md-sazzad-eee/ATLAS/02_electronics/agent_controller/atlas_agent_ctrl_schematic.png

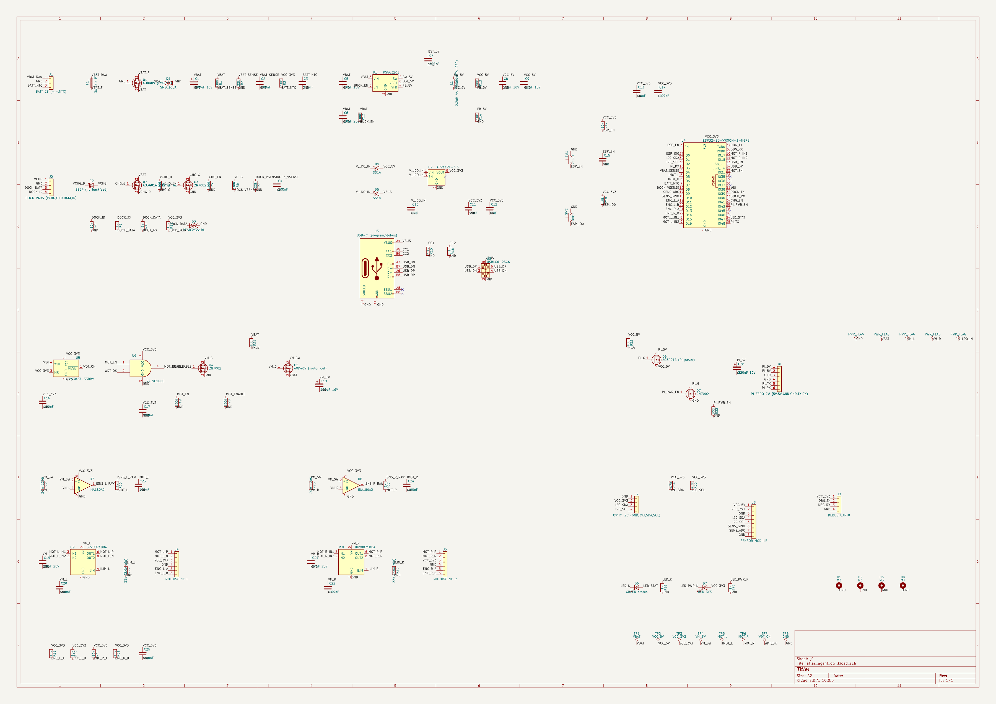
02_electronics/agent_controller/atlas_agent_ctrl_schematic.png
