md-sazzad-eee/ATLAS/02_electronics/agent_controller/board_top_render.png

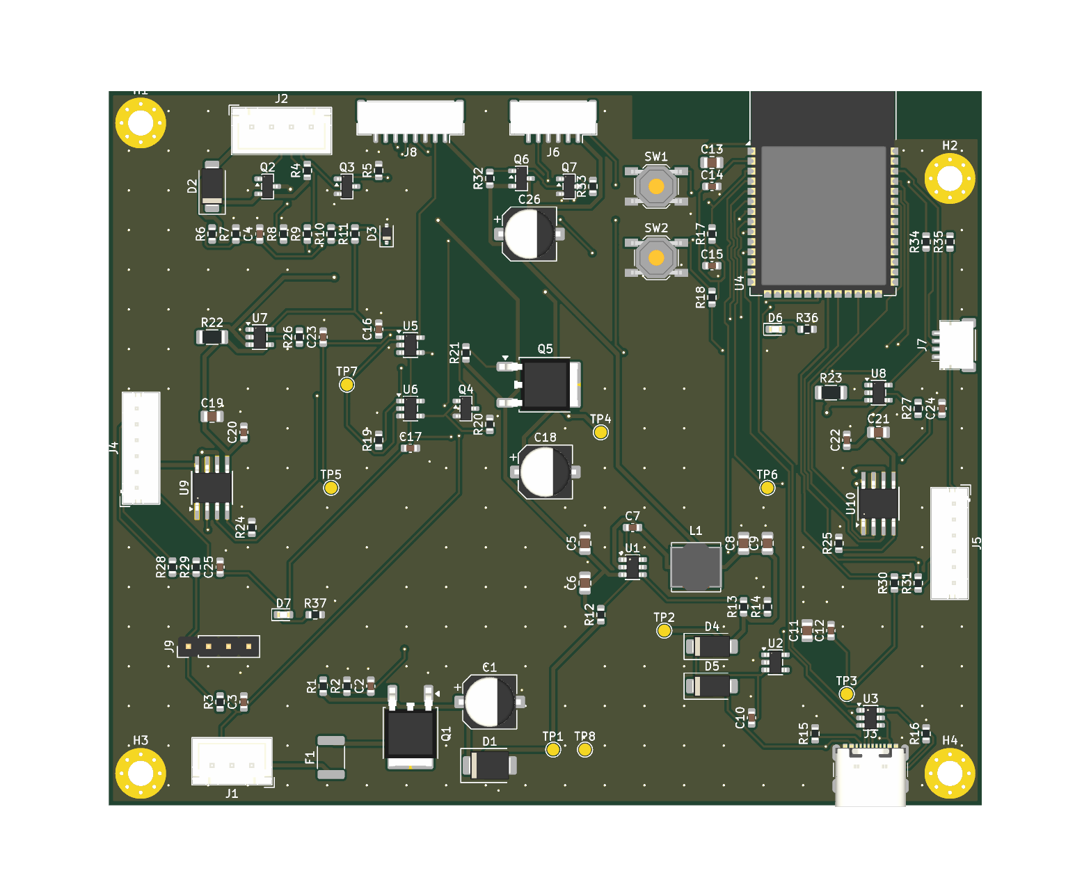
02_electronics/agent_controller/board_top_render.png
