md-sazzad-eee/ATLAS/05_simulation/matlab/results/torque_speed_requirements.png

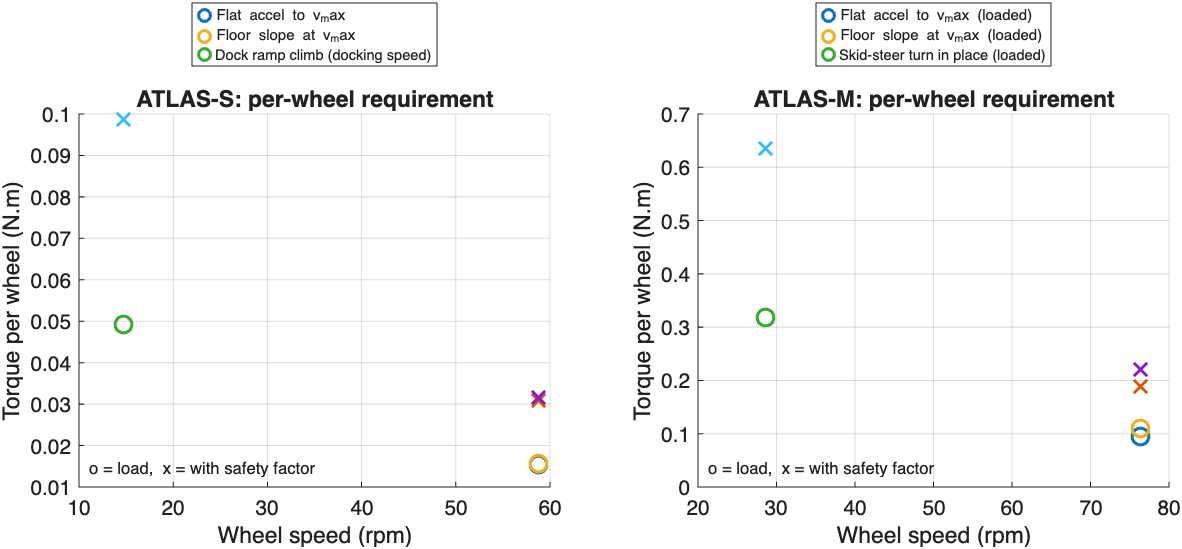
05_simulation/matlab/results/torque_speed_requirements.png
