md-sazzad-eee/ATLAS/07_documentation/figures/agent_boardB_fit.png

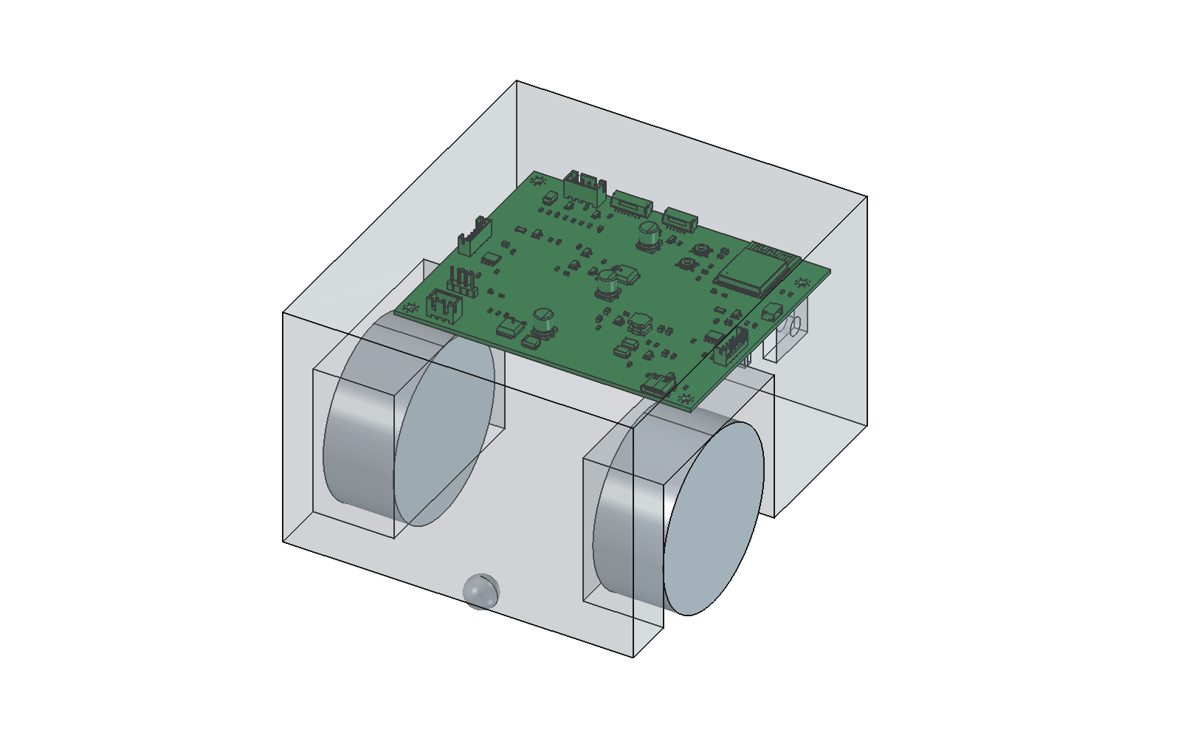
07_documentation/figures/agent_boardB_fit.png
