md-sazzad-eee/ATLAS/02_electronics/agent_controller/fab/atlas_agent_ctrl_bom.csv

Refs | Value | Footprint | Qty | DNP
C1 | 100uF 16V | Capacitor_SMD:CP_Elec_6.3x7.7 | 1
C2 | 100nF | Capacitor_SMD:C_0603_1608Metric | 1
C3 | 100nF | Capacitor_SMD:C_0603_1608Metric | 1
C4 | 100nF | Capacitor_SMD:C_0603_1608Metric | 1
C5 | 10uF 25V | Capacitor_SMD:C_0805_2012Metric | 1
C6 | 10uF 25V | Capacitor_SMD:C_0805_2012Metric | 1
C7 | 100nF | Capacitor_SMD:C_0603_1608Metric | 1
C8 | 22uF 10V | Capacitor_SMD:C_0805_2012Metric | 1
C9 | 22uF 10V | Capacitor_SMD:C_0805_2012Metric | 1
C10 | 1uF | Capacitor_SMD:C_0603_1608Metric | 1
C11 | 10uF | Capacitor_SMD:C_0805_2012Metric | 1
C12 | 1uF | Capacitor_SMD:C_0603_1608Metric | 1
C13 | 10uF | Capacitor_SMD:C_0805_2012Metric | 1
C14 | 100nF | Capacitor_SMD:C_0603_1608Metric | 1
C15 | 1uF | Capacitor_SMD:C_0603_1608Metric | 1
C16 | 100nF | Capacitor_SMD:C_0603_1608Metric | 1
C17 | 100nF | Capacitor_SMD:C_0603_1608Metric | 1
C18 | 100uF 16V | Capacitor_SMD:CP_Elec_6.3x7.7 | 1
C19 | 10uF 25V | Capacitor_SMD:C_0805_2012Metric | 1
C20 | 100nF | Capacitor_SMD:C_0603_1608Metric | 1
C21 | 10uF 25V | Capacitor_SMD:C_0805_2012Metric | 1
C22 | 100nF | Capacitor_SMD:C_0603_1608Metric | 1
C23 | 100nF | Capacitor_SMD:C_0603_1608Metric | 1
C24 | 100nF | Capacitor_SMD:C_0603_1608Metric | 1
C25 | 100nF | Capacitor_SMD:C_0603_1608Metric | 1
C26 | 220uF 10V | Capacitor_SMD:CP_Elec_6.3x7.7 | 1
D1 | SMBJ10CA | Diode_SMD:D_SMB | 1
D2 | SS34 (no backfeed) | Diode_SMD:D_SMA | 1
D3 | PESD3V3S1BL | Diode_SMD:D_SOD-323 | 1
D4 | SS14 | Diode_SMD:D_SMA | 1
D5 | SS14 | Diode_SMD:D_SMA | 1
D6 | GREEN status | LED_SMD:LED_0603_1608Metric | 1
D7 | RED 3V3 | LED_SMD:LED_0603_1608Metric | 1
F1 | 3A hold PTC | Fuse:Fuse_1812_4532Metric | 1
H1 | M3 | MountingHole:MountingHole_3.2mm_M3_Pad_Via | 1
H2 | M3 | MountingHole:MountingHole_3.2mm_M3_Pad_Via | 1
H3 | M3 | MountingHole:MountingHole_3.2mm_M3_Pad_Via | 1
H4 | M3 | MountingHole:MountingHole_3.2mm_M3_Pad_Via | 1
J1 | BATT 2S (+,-,NTC) | Connector_JST:JST_XH_B3B-XH-A_1x03_P2.50mm_Vertical | 1
J2 | DOCK PADS (VCHG,GND,DATA,ID) | Connector_JST:JST_XH_B4B-XH-A_1x04_P2.50mm_Vertical | 1
J3 | USB-C (program/debug) | Connector_USB:USB_C_Receptacle_GCT_USB4105-xx-A_16P_TopMnt_Horizontal | 1
J4 | MOTOR+ENC L | Connector_JST:JST_PH_B6B-PH-K_1x06_P2.00mm_Vertical | 1
J5 | MOTOR+ENC R | Connector_JST:JST_PH_B6B-PH-K_1x06_P2.00mm_Vertical | 1
J6 | PI ZERO 2W (5V,5V,GND,GND,TX,RX) | Connector_JST:JST_GH_SM06B-GHS-TB_1x06-1MP_P1.25mm_Horizontal | 1
J7 | QWIIC I2C (GND,3V3,SDA,SCL) | Connector_JST:JST_SH_SM04B-SRSS-TB_1x04-1MP_P1.00mm_Horizontal | 1
J8 | SENSOR MODULE | Connector_JST:JST_GH_SM08B-GHS-TB_1x08-1MP_P1.25mm_Horizontal | 1
J9 | DEBUG UART0 | Connector_PinHeader_2.54mm:PinHeader_1x04_P2.54mm_Vertical | 1
L1 | 2.2uH 4A (SRN6045TA-2R2) | Inductor_SMD:L_Bourns_SRN6045TA | 1
Q1 | AOD409 (rev-pol) | Package_TO_SOT_SMD:TO-252-2 | 1
Q2 | AO3401A (charge sw) | Package_TO_SOT_SMD:SOT-23 | 1
Q3 | 2N7002 | Package_TO_SOT_SMD:SOT-23 | 1
Q4 | 2N7002 | Package_TO_SOT_SMD:SOT-23 | 1
Q5 | AOD409 (motor cut) | Package_TO_SOT_SMD:TO-252-2 | 1
Q6 | AO3401A (Pi power) | Package_TO_SOT_SMD:SOT-23 | 1
Q7 | 2N7002 | Package_TO_SOT_SMD:SOT-23 | 1
R1 | 100k | Resistor_SMD:R_0603_1608Metric | 1
R2 | 22k | Resistor_SMD:R_0603_1608Metric | 1
R3 | 10k | Resistor_SMD:R_0603_1608Metric | 1
R4 | 100k | Resistor_SMD:R_0603_1608Metric | 1
R5 | 100k | Resistor_SMD:R_0603_1608Metric | 1
R6 | 100k | Resistor_SMD:R_0603_1608Metric | 1
R7 | 22k | Resistor_SMD:R_0603_1608Metric | 1
R8 | 10k | Resistor_SMD:R_0603_1608Metric | 1
R9 | 1k | Resistor_SMD:R_0603_1608Metric | 1
R10 | 1k | Resistor_SMD:R_0603_1608Metric | 1
R11 | 10k | Resistor_SMD:R_0603_1608Metric | 1
R12 | 100k | Resistor_SMD:R_0603_1608Metric | 1
R13 | 56k | Resistor_SMD:R_0603_1608Metric | 1
R14 | 10k | Resistor_SMD:R_0603_1608Metric | 1
R15 | 5.1k | Resistor_SMD:R_0603_1608Metric | 1
R16 | 5.1k | Resistor_SMD:R_0603_1608Metric | 1
R17 | 10k | Resistor_SMD:R_0603_1608Metric | 1
R18 | 10k | Resistor_SMD:R_0603_1608Metric | 1
R19 | 100k | Resistor_SMD:R_0603_1608Metric | 1
R20 | 100k | Resistor_SMD:R_0603_1608Metric | 1
R21 | 100k | Resistor_SMD:R_0603_1608Metric | 1
R22 | 20m 1206 | Resistor_SMD:R_1206_3216Metric | 1
R23 | 20m 1206 | Resistor_SMD:R_1206_3216Metric | 1
R24 | 33k (2.0A trip) | Resistor_SMD:R_0603_1608Metric | 1
R25 | 33k (2.0A trip) | Resistor_SMD:R_0603_1608Metric | 1
R26 | 1k | Resistor_SMD:R_0603_1608Metric | 1
R27 | 1k | Resistor_SMD:R_0603_1608Metric | 1
R28 | 10k | Resistor_SMD:R_0603_1608Metric | 1
R29 | 10k | Resistor_SMD:R_0603_1608Metric | 1
R30 | 10k | Resistor_SMD:R_0603_1608Metric | 1
R31 | 10k | Resistor_SMD:R_0603_1608Metric | 1
R32 | 100k | Resistor_SMD:R_0603_1608Metric | 1
R33 | 100k | Resistor_SMD:R_0603_1608Metric | 1
R34 | 4.7k | Resistor_SMD:R_0603_1608Metric | 1
R35 | 4.7k | Resistor_SMD:R_0603_1608Metric | 1
R36 | 1k | Resistor_SMD:R_0603_1608Metric | 1
R37 | 1k | Resistor_SMD:R_0603_1608Metric | 1
SW1 | RESET | Button_Switch_SMD:SW_SPST_TL3342 | 1
SW2 | BOOT | Button_Switch_SMD:SW_SPST_TL3342 | 1
TP1 | VBAT | TestPoint:TestPoint_Pad_D1.5mm | 1
TP2 | VCC_5V | TestPoint:TestPoint_Pad_D1.5mm | 1
TP3 | VCC_3V3 | TestPoint:TestPoint_Pad_D1.5mm | 1
TP4 | VM_SW | TestPoint:TestPoint_Pad_D1.5mm | 1
TP5 | IMOT_L | TestPoint:TestPoint_Pad_D1.5mm | 1
TP6 | IMOT_R | TestPoint:TestPoint_Pad_D1.5mm | 1
TP7 | WDT_OK | TestPoint:TestPoint_Pad_D1.5mm | 1
TP8 | GND | TestPoint:TestPoint_Pad_D1.5mm | 1
U1 | TPS563201 | Package_TO_SOT_SMD:SOT-23-6 | 1
U2 | AP2112K-3.3 | Package_TO_SOT_SMD:SOT-23-5 | 1
U3 | USBLC6-2SC6 | Package_TO_SOT_SMD:SOT-23-6 | 1
U4 | ESP32-S3-WROOM-1-N8R8 | RF_Module:ESP32-S3-WROOM-1 | 1
U5 | TPS3823-33DBV | Package_TO_SOT_SMD:SOT-23-5 | 1
U6 | 74LVC1G08 | Package_TO_SOT_SMD:SOT-23-5 | 1
U7 | INA180A2 | Package_TO_SOT_SMD:SOT-23-5 | 1
U8 | INA180A2 | Package_TO_SOT_SMD:SOT-23-5 | 1
U9 | DRV8871DDA | Package_SO:Texas_HTSOP-8-1EP_3.9x4.9mm_P1.27mm_EP2.95x4.9mm_Mask2.4x3.1mm_ThermalVias | 1
U10 | DRV8871DDA | Package_SO:Texas_HTSOP-8-1EP_3.9x4.9mm_P1.27mm_EP2.95x4.9mm_Mask2.4x3.1mm_ThermalVias | 1
