md-sazzad-eee/ATLAS/02_electronics/carrier_controller/fab/atlas_carrier_ctrl_bom.csv

Refs | Value | Footprint | Qty | DNP
BZ1 | 5V magnetic buzzer | Buzzer_Beeper:Buzzer_12x9.5RM7.6 | 1
C1 | 470uF 25V | Capacitor_SMD:CP_Elec_10x10.5 | 1
C2 | 100nF | Capacitor_SMD:C_0603_1608Metric | 1
C3 | 10uF 25V | Capacitor_SMD:C_1206_3216Metric | 1
C4 | 10uF 25V | Capacitor_SMD:C_1206_3216Metric | 1
C5 | 100nF | Capacitor_SMD:C_0603_1608Metric | 1
C6 | 100nF | Capacitor_SMD:C_0603_1608Metric | 1
C7 | 22uF 10V | Capacitor_SMD:C_1206_3216Metric | 1
C8 | 22uF 10V | Capacitor_SMD:C_1206_3216Metric | 1
C9 | 1uF | Capacitor_SMD:C_0603_1608Metric | 1
C10 | 10uF | Capacitor_SMD:C_0805_2012Metric | 1
C11 | 10uF | Capacitor_SMD:C_0805_2012Metric | 1
C12 | 100nF | Capacitor_SMD:C_0603_1608Metric | 1
C13 | 1uF | Capacitor_SMD:C_0603_1608Metric | 1
C14 | 100nF | Capacitor_SMD:C_0603_1608Metric | 1
C15 | 100nF | Capacitor_SMD:C_0603_1608Metric | 1
C16 | 100nF | Capacitor_SMD:C_0603_1608Metric | 1
C17 | 100nF | Capacitor_SMD:C_0603_1608Metric | 1
C18 | 100nF | Capacitor_SMD:C_0603_1608Metric | 1
C19 | 220uF 25V | Capacitor_SMD:CP_Elec_8x10 | 1
C20 | 100nF | Capacitor_SMD:C_0603_1608Metric | 1
C21 | 100nF | Capacitor_SMD:C_0603_1608Metric | 1
C22 | 100nF | Capacitor_SMD:C_0603_1608Metric | 1
C23 | 100nF | Capacitor_SMD:C_0603_1608Metric | 1
C24 | 100nF | Capacitor_SMD:C_0603_1608Metric | 1
C30 | 100nF | Capacitor_SMD:C_0603_1608Metric | 1
C31 | 47uF 25V | Capacitor_SMD:CP_Elec_6.3x7.7 | 1
C32 | 100nF | Capacitor_SMD:C_0603_1608Metric | 1
C33 | 100nF | Capacitor_SMD:C_0603_1608Metric | 1
C34 | 100nF | Capacitor_SMD:C_0603_1608Metric | 1
C35 | 47uF 25V | Capacitor_SMD:CP_Elec_6.3x7.7 | 1
C36 | 100nF | Capacitor_SMD:C_0603_1608Metric | 1
C37 | 100nF | Capacitor_SMD:C_0603_1608Metric | 1
C38 | 100nF | Capacitor_SMD:C_0603_1608Metric | 1
C39 | 47uF 25V | Capacitor_SMD:CP_Elec_6.3x7.7 | 1
C40 | 100nF | Capacitor_SMD:C_0603_1608Metric | 1
C41 | 100nF | Capacitor_SMD:C_0603_1608Metric | 1
C42 | 100nF | Capacitor_SMD:C_0603_1608Metric | 1
C43 | 47uF 25V | Capacitor_SMD:CP_Elec_6.3x7.7 | 1
C44 | 100nF | Capacitor_SMD:C_0603_1608Metric | 1
C45 | 100nF | Capacitor_SMD:C_0603_1608Metric | 1
D1 | SMBJ16CA | Diode_SMD:D_SMB | 1
D2 | SS14 | Diode_SMD:D_SMA | 1
D3 | SS14 | Diode_SMD:D_SMA | 1
D4 | RED motors armed | LED_SMD:LED_0603_1608Metric | 1
D5 | SS34 flyback | Diode_SMD:D_SMA | 1
D6 | SS34 flyback | Diode_SMD:D_SMA | 1
D7 | GREEN status | LED_SMD:LED_0603_1608Metric | 1
F1 | 15A mini blade | Fuse:Fuseholder_Blade_Mini_Keystone_3568 | 1
J1 | BATT 4S (+,-) | Connector_AMASS:AMASS_XT60PW-M_1x02_P7.20mm_Horizontal | 1
J2 | SBC POWER OUT (VBAT,GND) | Connector_AMASS:AMASS_XT30PW-M_1x02_P2.50mm_Horizontal | 1
J3 | BOARD C POWER (VBAT,GND) | Connector_AMASS:AMASS_XT30PW-M_1x02_P2.50mm_Horizontal | 1
J4 | USB-C (ROS 2 link) | Connector_USB:USB_C_Receptacle_GCT_USB4105-xx-A_16P_TopMnt_Horizontal | 1
J5 | E-STOP (NC) | Connector_JST:JST_XH_B2B-XH-A_1x02_P2.50mm_Vertical | 1
J6 | BAY 1 SENSORS (GND,SEATED,LATCHED_N) | Connector_JST:JST_PH_B3B-PH-K_1x03_P2.00mm_Vertical | 1
J7 | BAY 2 SENSORS (GND,SEATED,LATCHED_N) | Connector_JST:JST_PH_B3B-PH-K_1x03_P2.00mm_Vertical | 1
J8 | LATCH 1 SOLENOID (12V) | Connector_JST:JST_VH_B2P-VH_1x02_P3.96mm_Vertical | 1
J9 | LATCH 2 SOLENOID (12V) | Connector_JST:JST_VH_B2P-VH_1x02_P3.96mm_Vertical | 1
J10 | QWIIC I2C (IMU) | Connector_JST:JST_SH_SM04B-SRSS-TB_1x04-1MP_P1.00mm_Horizontal | 1
J11 | TO BOARD C | Connector_PinHeader_2.54mm:PinHeader_2x08_P2.54mm_Vertical | 1
J12 | MOTOR LF | Connector_JST:JST_VH_B2P-VH_1x02_P3.96mm_Vertical | 1
J13 | MOTOR LR | Connector_JST:JST_VH_B2P-VH_1x02_P3.96mm_Vertical | 1
J14 | MOTOR RF | Connector_JST:JST_VH_B2P-VH_1x02_P3.96mm_Vertical | 1
J15 | MOTOR RR | Connector_JST:JST_VH_B2P-VH_1x02_P3.96mm_Vertical | 1
J16 | ENCODER LF | Connector_JST:JST_PH_B4B-PH-K_1x04_P2.00mm_Vertical | 1
J17 | ENCODER LR | Connector_JST:JST_PH_B4B-PH-K_1x04_P2.00mm_Vertical | 1
J18 | ENCODER RF | Connector_JST:JST_PH_B4B-PH-K_1x04_P2.00mm_Vertical | 1
J19 | ENCODER RR | Connector_JST:JST_PH_B4B-PH-K_1x04_P2.00mm_Vertical | 1
L1 | 10uH 4A | Inductor_SMD:L_Bourns_SRR1260 | 1
Q1 | AOD409 (rev-pol) | Package_TO_SOT_SMD:TO-252-2 | 1
Q2 | 2N7002 | Package_TO_SOT_SMD:SOT-23 | 1
Q3 | AOD409 (motor rail) | Package_TO_SOT_SMD:TO-252-2 | 1
Q4 | AO3400A | Package_TO_SOT_SMD:SOT-23 | 1
Q5 | AO3400A | Package_TO_SOT_SMD:SOT-23 | 1
Q6 | AO3400A | Package_TO_SOT_SMD:SOT-23 | 1
R1 | 100k | Resistor_SMD:R_0603_1608Metric | 1
R2 | 18k | Resistor_SMD:R_0603_1608Metric | 1
R3 | 100k | Resistor_SMD:R_0603_1608Metric | 1
R4 | 20k | Resistor_SMD:R_0603_1608Metric | 1
R5 | 75k 1% | Resistor_SMD:R_0603_1608Metric | 1
R6 | 10k 1% | Resistor_SMD:R_0603_1608Metric | 1
R7 | 5.1k | Resistor_SMD:R_0603_1608Metric | 1
R8 | 5.1k | Resistor_SMD:R_0603_1608Metric | 1
R9 | 10k | Resistor_SMD:R_0603_1608Metric | 1
R10 | 10k | Resistor_SMD:R_0603_1608Metric | 1
R11 | 10k | Resistor_SMD:R_0603_1608Metric | 1
R12 | 100k | Resistor_SMD:R_0603_1608Metric | 1
R13 | 100k | Resistor_SMD:R_0603_1608Metric | 1
R14 | 100k | Resistor_SMD:R_0603_1608Metric | 1
R15 | 1k | Resistor_SMD:R_0603_1608Metric | 1
R16 | 10k | Resistor_SMD:R_0603_1608Metric | 1
R17 | 10k | Resistor_SMD:R_0603_1608Metric | 1
R18 | 10k | Resistor_SMD:R_0603_1608Metric | 1
R19 | 10k | Resistor_SMD:R_0603_1608Metric | 1
R21 | 100 | Resistor_SMD:R_0603_1608Metric | 1
R22 | 100k | Resistor_SMD:R_0603_1608Metric | 1
R23 | 100 | Resistor_SMD:R_0603_1608Metric | 1
R24 | 100k | Resistor_SMD:R_0603_1608Metric | 1
R25 | 10k | Resistor_SMD:R_0603_1608Metric | 1
R26 | 4.7k | Resistor_SMD:R_0603_1608Metric | 1
R27 | 4.7k | Resistor_SMD:R_0603_1608Metric | 1
R28 | 1k | Resistor_SMD:R_0603_1608Metric | 1
R29 | 100k | Resistor_SMD:R_0603_1608Metric | 1
R30 | 100k | Resistor_SMD:R_0603_1608Metric | 1
R31 | 100k | Resistor_SMD:R_0603_1608Metric | 1
R40 | 20m 1% | Resistor_SMD:R_1206_3216Metric | 1
R41 | 1k | Resistor_SMD:R_0603_1608Metric | 1
R42 | 22k (2.9A trip) | Resistor_SMD:R_0603_1608Metric | 1
R43 | 10k | Resistor_SMD:R_0603_1608Metric | 1
R44 | 10k | Resistor_SMD:R_0603_1608Metric | 1
R50 | 20m 1% | Resistor_SMD:R_1206_3216Metric | 1
R51 | 1k | Resistor_SMD:R_0603_1608Metric | 1
R52 | 22k (2.9A trip) | Resistor_SMD:R_0603_1608Metric | 1
R53 | 10k | Resistor_SMD:R_0603_1608Metric | 1
R54 | 10k | Resistor_SMD:R_0603_1608Metric | 1
R60 | 20m 1% | Resistor_SMD:R_1206_3216Metric | 1
R61 | 1k | Resistor_SMD:R_0603_1608Metric | 1
R62 | 22k (2.9A trip) | Resistor_SMD:R_0603_1608Metric | 1
R63 | 10k | Resistor_SMD:R_0603_1608Metric | 1
R64 | 10k | Resistor_SMD:R_0603_1608Metric | 1
R70 | 20m 1% | Resistor_SMD:R_1206_3216Metric | 1
R71 | 1k | Resistor_SMD:R_0603_1608Metric | 1
R72 | 22k (2.9A trip) | Resistor_SMD:R_0603_1608Metric | 1
R73 | 10k | Resistor_SMD:R_0603_1608Metric | 1
R74 | 10k | Resistor_SMD:R_0603_1608Metric | 1
SW1 | RESET | Button_Switch_SMD:SW_SPST_TL3342 | 1
SW2 | BOOT | Button_Switch_SMD:SW_SPST_TL3342 | 1
U1 | TPS54302 | Package_TO_SOT_SMD:SOT-23-6 | 1
U2 | AP2112K-3.3 | Package_TO_SOT_SMD:SOT-23-5 | 1
U3 | USBLC6-2SC6 | Package_TO_SOT_SMD:SOT-23-6 | 1
U4 | ESP32-S3-WROOM-1-N8 | RF_Module:ESP32-S3-WROOM-1 | 1
U5 | TPS3823-33DBV | Package_TO_SOT_SMD:SOT-23-5 | 1
U6 | 74LVC1G00 | Package_TO_SOT_SMD:SOT-23-5 | 1
U7 | 74LVC1G00 | Package_TO_SOT_SMD:SOT-23-5 | 1
U8 | 74LVC1G11 | Package_TO_SOT_SMD:SOT-23-6 | 1
U9 | 74LVC1G11 | Package_TO_SOT_SMD:SOT-23-6 | 1
U10 | TCA9534PWR | Package_SO:TSSOP-16_4.4x5mm_P0.65mm | 1
U11 | INA180A1 | Package_TO_SOT_SMD:SOT-23-5 | 1
U12 | INA180A1 | Package_TO_SOT_SMD:SOT-23-5 | 1
U13 | INA180A1 | Package_TO_SOT_SMD:SOT-23-5 | 1
U14 | INA180A1 | Package_TO_SOT_SMD:SOT-23-5 | 1
U15 | DRV8871DDA | Package_SO:Texas_HTSOP-8-1EP_3.9x4.9mm_P1.27mm_EP2.95x4.9mm_Mask2.4x3.1mm_ThermalVias | 1
U16 | DRV8871DDA | Package_SO:Texas_HTSOP-8-1EP_3.9x4.9mm_P1.27mm_EP2.95x4.9mm_Mask2.4x3.1mm_ThermalVias | 1
U17 | DRV8871DDA | Package_SO:Texas_HTSOP-8-1EP_3.9x4.9mm_P1.27mm_EP2.95x4.9mm_Mask2.4x3.1mm_ThermalVias | 1
U18 | DRV8871DDA | Package_SO:Texas_HTSOP-8-1EP_3.9x4.9mm_P1.27mm_EP2.95x4.9mm_Mask2.4x3.1mm_ThermalVias | 1
