md-sazzad-eee/ATLAS/01_mechanical/atlas_main/ATLAS_carrier_assembly.FCStd

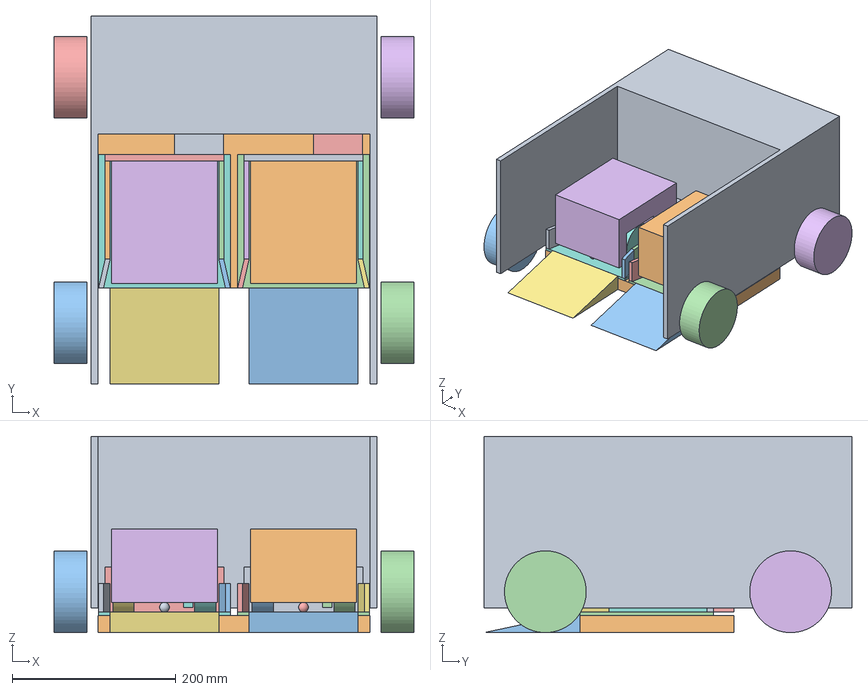
[picture p5: CAD file, 2026-10-15]
01_mechanical/atlas_main/ATLAS_carrier_assembly.FCStd
440.0 x 450.0 x 240.0 mm
Carrier_Chassis
Carrier_Bay_Pan
Carrier_Wheel_L0
Carrier_Wheel_R0
Carrier_Wheel_L1
Carrier_Wheel_R1
Bay1_Ramp
Bay1_Dock_Base
Bay1_Left_Funnel
Bay1_Left_Guide
Bay1_Right_Funnel
Bay1_Right_Guide
Bay1_Front_Stop
Bay1_Contact_Block
Bay1_Contact_Pins
Bay1_Seated_Sensor
Bay1_Latch_Housing
Bay1_Latch_Pin
Bay1_Latch_Body
Bay1_Actuator_Mount
Bay1_Latch_Hall_Sensor
Agent1_Agent_Body
Agent1_Agent_Wheel_L
Agent1_Agent_Wheel_R
Agent1_Agent_Caster
Agent1_Agent_Docking_Face
Bay2_Ramp
Bay2_Dock_Base
Bay2_Left_Funnel
Bay2_Left_Guide
Bay2_Right_Funnel
Bay2_Right_Guide
Bay2_Front_Stop
Bay2_Contact_Block
Bay2_Contact_Pins
Bay2_Seated_Sensor
Bay2_Latch_Housing
Bay2_Latch_Pin
Bay2_Latch_Body
Bay2_Actuator_Mount
Bay2_Latch_Hall_Sensor
Agent2_Agent_Body
Agent2_Agent_Wheel_L
Agent2_Agent_Wheel_R
Agent2_Agent_Caster
Agent2_Agent_Docking_Face
