md-sazzad-eee/ATLAS/01_mechanical/atlas_scout/ATLAS_agent.FCStd

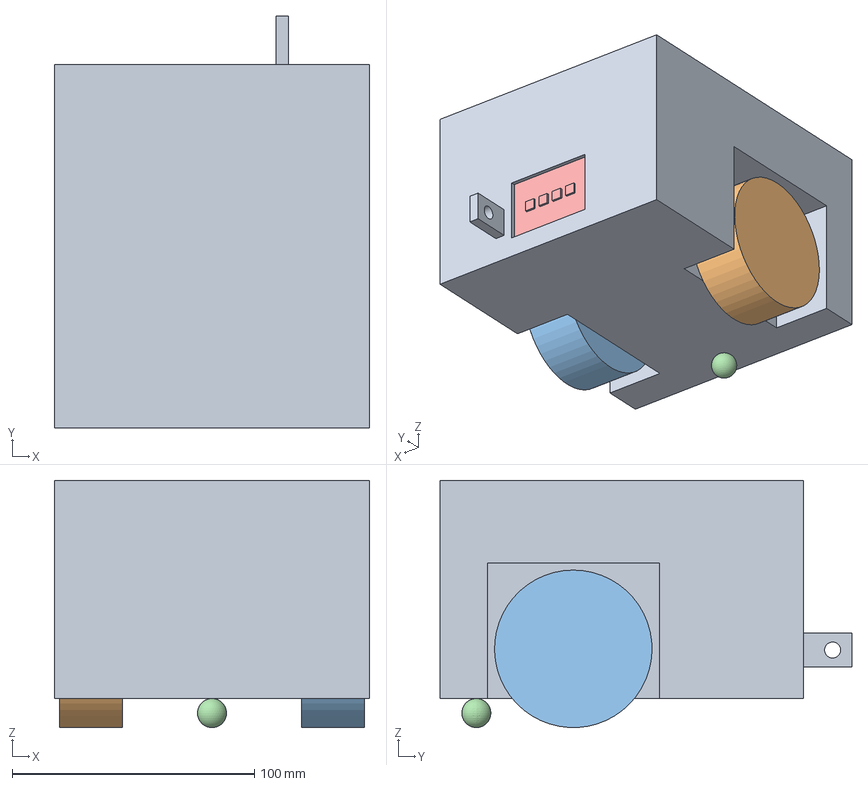
[picture p6: CAD file, 2026-10-15]
01_mechanical/atlas_scout/ATLAS_agent.FCStd
130.0 x 170.0 x 102.0 mm
Agent_Body
Agent_Wheel_L
Agent_Wheel_R
Agent_Caster
Agent_Docking_Face
