md-sazzad-eee/ATLAS/01_mechanical/common_interfaces/Agent_Docking_Face.step

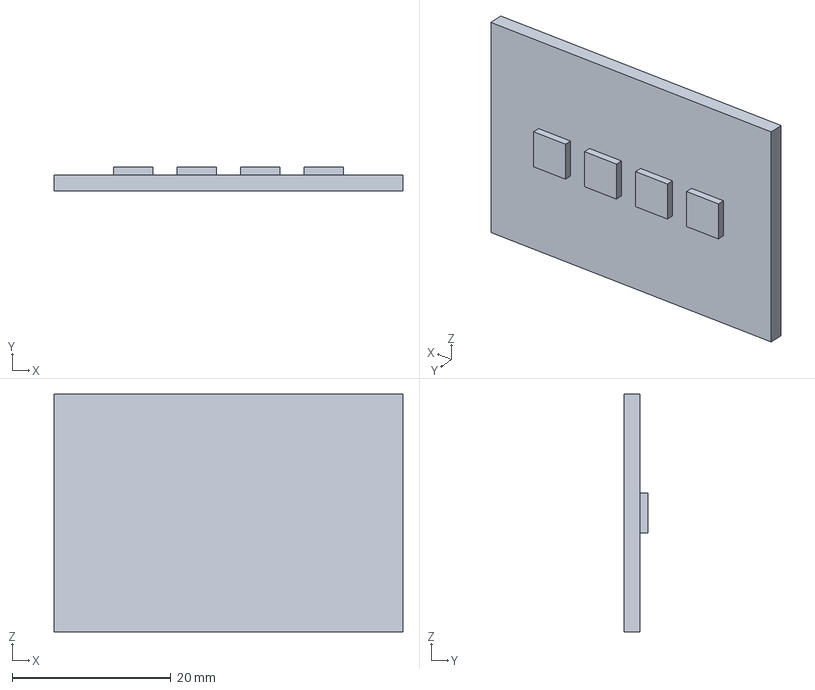
[picture p7: CAD file, 2026-10-15]
01_mechanical/common_interfaces/Agent_Docking_Face.step
44.0 x 3.00 x 30.0 mm
