md-sazzad-eee/ATLAS/01_mechanical/docking_system/ATLAS_docking_bay.FCStd

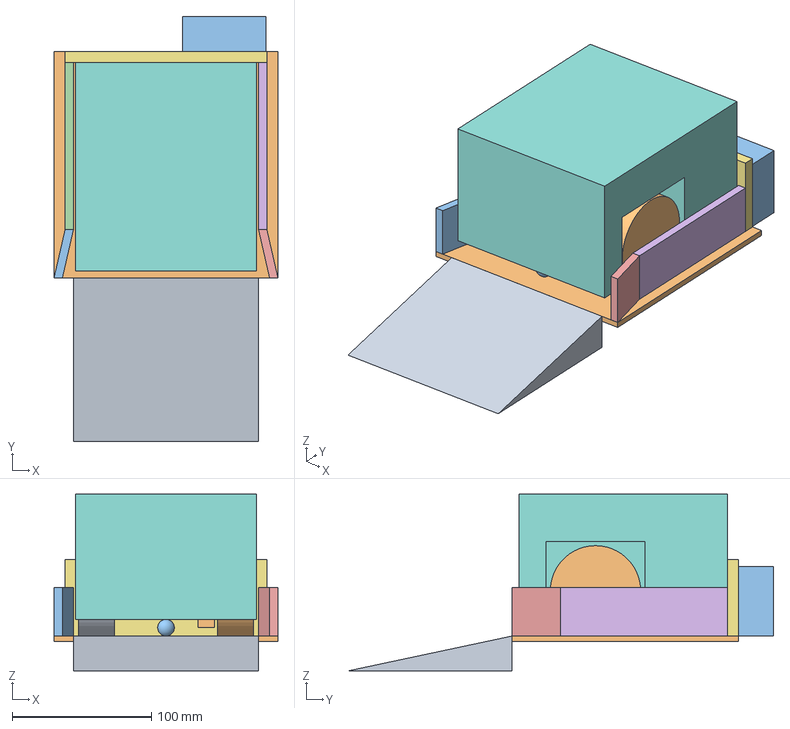
[picture p8: CAD file, 2026-10-15]
01_mechanical/docking_system/ATLAS_docking_bay.FCStd
161.0 x 305.6 x 127.0 mm
Ramp
Dock_Base
Left_Funnel
Left_Guide
Right_Funnel
Right_Guide
Front_Stop
Contact_Block
Contact_Pins
Seated_Sensor
Latch_Housing
Latch_Pin
Latch_Body
Actuator_Mount
Latch_Hall_Sensor
Seated_Agent_Body
Seated_Agent_Wheel_L
Seated_Agent_Wheel_R
Seated_Agent_Caster
Seated_Agent_Docking_Face
