md-sazzad-eee/ATLAS/01_mechanical/docking_system/test_coupons/Dock_Test_Gauge_clear_2.0mm.stl

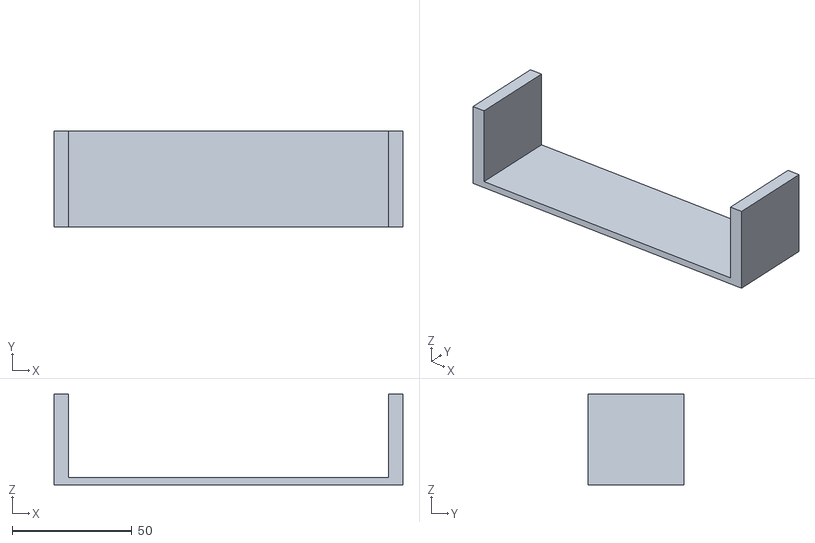
[picture p9: CAD file, 2026-10-15]
01_mechanical/docking_system/test_coupons/Dock_Test_Gauge_clear_2.0mm.stl
146.0 x 40.0 x 38.0
