md-sazzad-eee/ATLAS/02_electronics/agent_controller/atlas_agent_ctrl.step

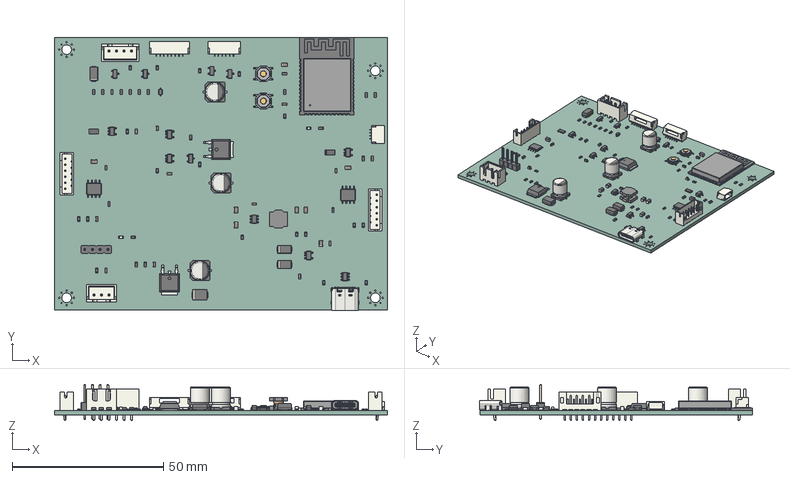
[picture p10: CAD file, 2026-10-15]
02_electronics/agent_controller/atlas_agent_ctrl.step
110.0 x 90.2 x 11.9 mm
D_SOD-323
SOT-23-5 x 5
JST_SM06B_GHS_TB
Texas_HTSOP_8_1EP_39x49mm_P127mm_EP285x49mm_Mask24x31mm_ThermalVias x 2
R_0603_1608Metric x 35
C_0603_1608Metric x 15
932d09b3-9c39-11ed-93f0-dde97e994e83_part x 2
932d09b4-9c39-11ed-93f0-dde97e994e83_part x 2
932d09b5-9c39-11ed-93f0-dde97e994e83_part x 2
LED_0603_1608Metric x 2
SOT-23 x 5
JST_B4B_XH_A
JST_B6B_PH_K x 2
USB_C_Receptacle_16P_TopMnt_Horizontal_GCT_USB4105-xx-A
C_0805_2012Metric x 8
D_SMB
R_1206_3216Metric x 2
CP_Elec_63x77 x 3
D_SMA x 3
JST_SM08B_GHS_TB
SW_SPST_TL3342 x 2
PinHeader_1x04_P254mm_Vertical
SOT-23-6 x 2
ESP32-S3-WROOM-1
JST_B3B_XH_A
JST_SH_SM04B-SRSS-TB_1x04-1MP_P1.00mm_Horizontal
L_Bourns_SRN6045TA
atlas_agent_ctrl_PCB
