md-sazzad-eee/ATLAS/02_electronics/carrier_controller/atlas_carrier_ctrl.step

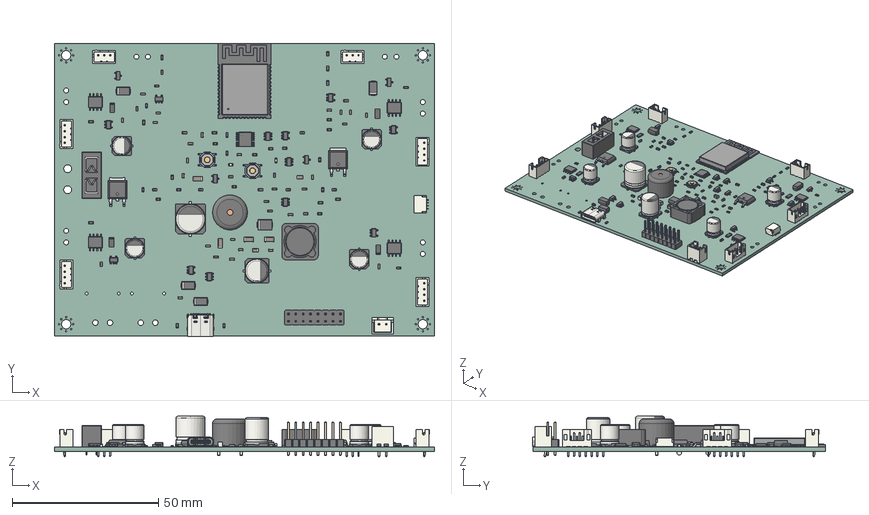
[picture p11: CAD file, 2026-10-15]
02_electronics/carrier_controller/atlas_carrier_ctrl.step
130.0 x 100.2 x 13.9 mm
SOT-23-5 x 8
R_0603_1608Metric x 46
SOT-23-6 x 4
JST_B4B_PH_K x 4
SOT-23 x 4
932d09b3-9c39-11ed-93f0-dde97e994e83_part x 2
932d09b4-9c39-11ed-93f0-dde97e994e83_part x 2
932d09b5-9c39-11ed-93f0-dde97e994e83_part x 2
R_1206_3216Metric x 4
C_0603_1608Metric x 28
D_SMA x 4
CP_Elec_63x77 x 4
C_0805_2012Metric x 2
JST_B3B_PH_K x 2
Buzzer_12x95RM76
SRR1260
SW_SPST_TL3342 x 2
C_1206_3216Metric x 4
Texas_HTSOP_8_1EP_39x49mm_P127mm_EP285x49mm_Mask24x31mm_ThermalVias x 4
ESP32-S3-WROOM-1
TSSOP-16_4.4x5mm_P0.65mm
USB_C_Receptacle_16P_TopMnt_Horizontal_GCT_USB4105-xx-A
JST_B2B_XH_A
JST_SH_SM04B-SRSS-TB_1x04-1MP_P1.00mm_Horizontal
D_SMB
CP_Elec_10x105
CP_Elec_8x10
A_Keystone_3568
PinHeader_2x08_P254mm_Vertical
LED_0603_1608Metric x 2
atlas_carrier_ctrl_PCB
