md-sazzad-eee/ATLAS/02_electronics/dock_charger/atlas_dock_charger.step

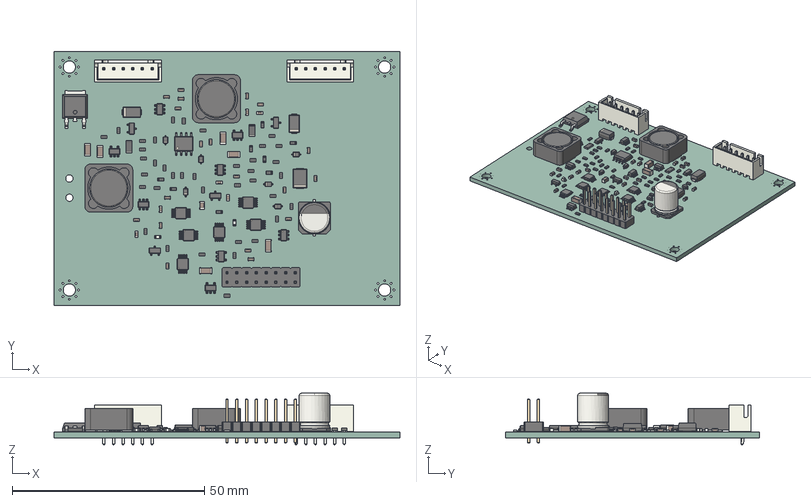
[picture p12: CAD file, 2026-10-15]
02_electronics/dock_charger/atlas_dock_charger.step
90.0 x 66.0 x 13.4 mm
C_0603_1608Metric x 25
D_SOD-323 x 6
R_0603_1608Metric x 46
LED_0603_1608Metric x 2
SOT-23-5 x 4
JST_B6B_XH_A x 2
C_1206_3216Metric x 6
PinHeader_2x08_P254mm_Vertical
932d09b3-9c39-11ed-93f0-dde97e994e83_part
932d09b4-9c39-11ed-93f0-dde97e994e83_part
932d09b5-9c39-11ed-93f0-dde97e994e83_part
D_SMA x 2
MSOP-10_3x3mm_P0.5mm x 6
SOIC-8_3.9x4.9mm_P1.27mm
SOT-23-6 x 4
SRR1260 x 2
SOT-23 x 4
R_1206_3216Metric x 2
C_0805_2012Metric
D_SMB
CP_Elec_8x10
atlas_dock_charger_PCB
