md-sazzad-eee/ATLAS/01_mechanical/atlas_scout/ATLAS_agent_with_boardB.FCStd

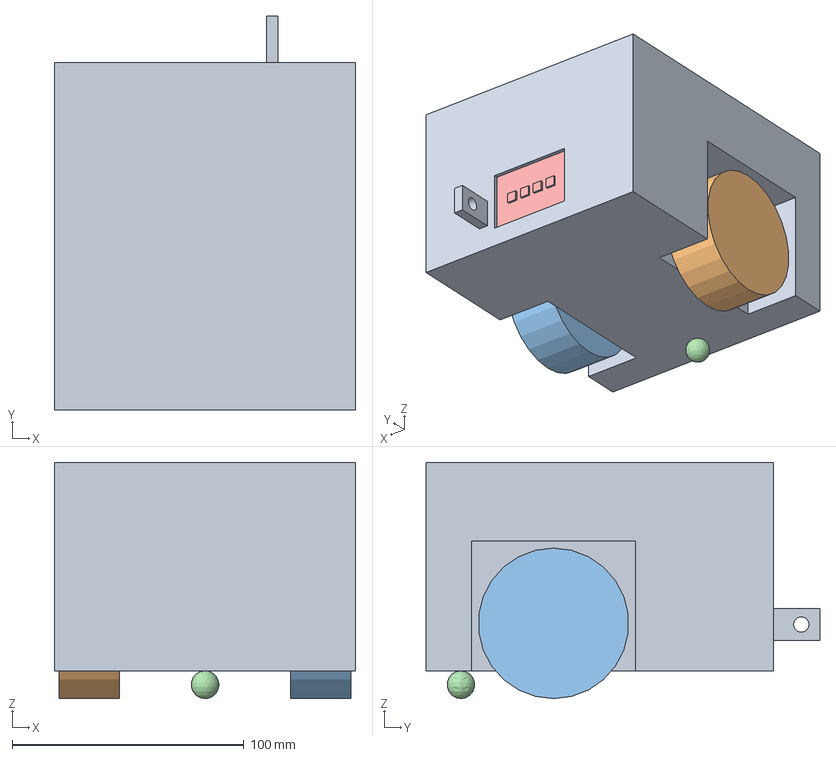
[picture p13: CAD file, 2026-10-15]
01_mechanical/atlas_scout/ATLAS_agent_with_boardB.FCStd
130.0 x 170.0 x 102.0 mm
Agent_Body
Agent_Wheel_L
Agent_Wheel_R
Agent_Caster
Agent_Docking_Face
BoardB_PCB
