md-sazzad-eee/ATLAS/01_mechanical/common_interfaces/ATLAS_docking_bay.step

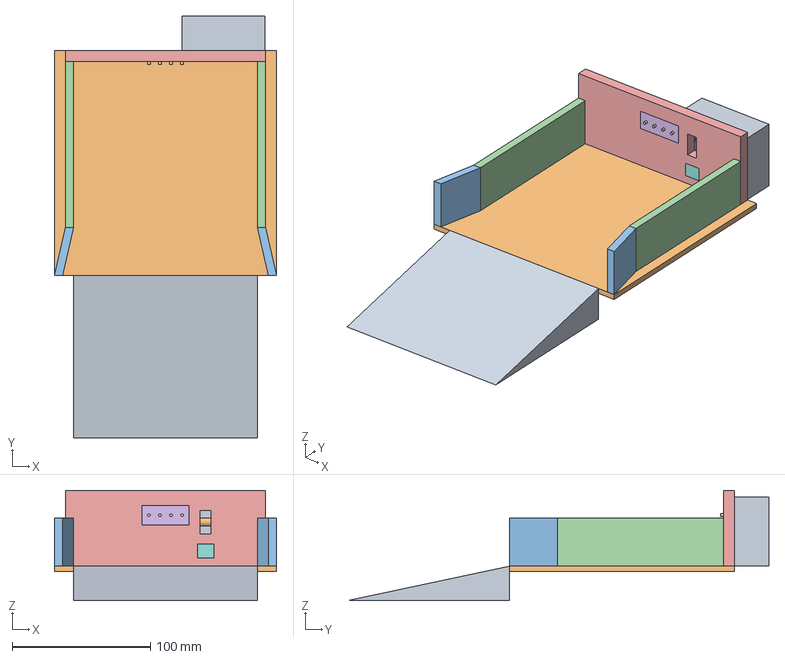
[picture p14: CAD file, 2026-10-15]
01_mechanical/common_interfaces/ATLAS_docking_bay.step
161.0 x 305.6 x 80.0 mm
