md-sazzad-eee/ATLAS/(list of files, cad)

Other CAD files:
01_mechanical/common_interfaces/ATLAS_carrier_assembly.step
01_mechanical/docking_system/test_coupons/Dock_Test_Gauge_clear_3.0mm.stl
01_mechanical/common_interfaces/ATLAS_agent.step
01_mechanical/docking_system/test_coupons/Dock_Test_Gauge_clear_0.5mm.stl
01_mechanical/docking_system/test_coupons/Dock_Test_Gauge_clear_1.0mm.stl
