md-sazzad-eee/ATLAS/05_simulation/matlab/results/speed_loop_step.png

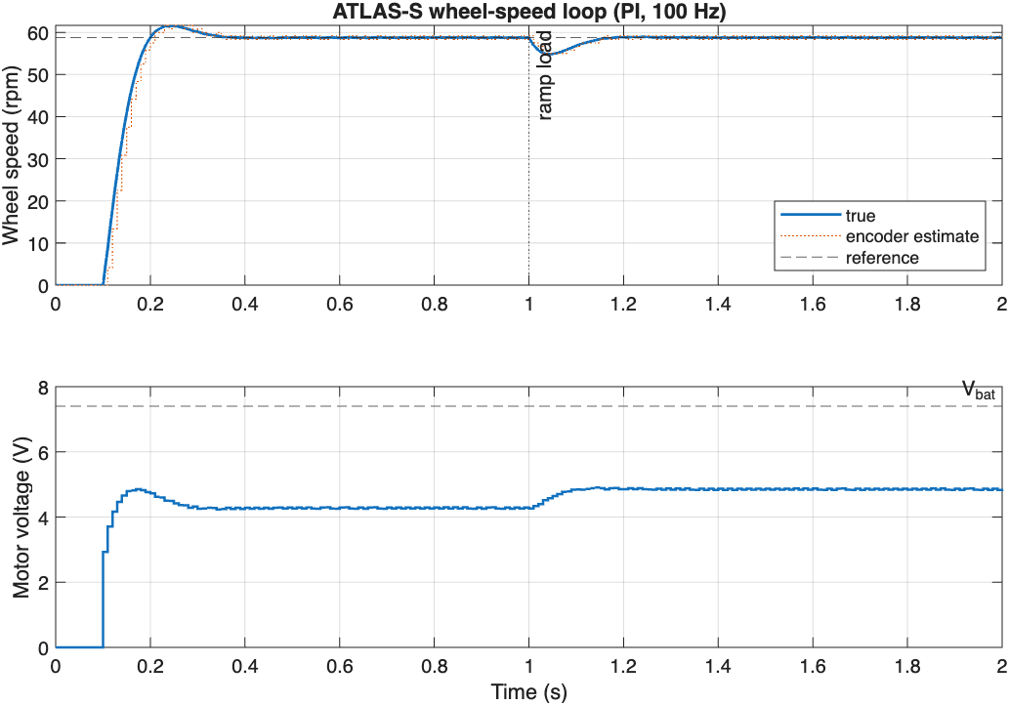
05_simulation/matlab/results/speed_loop_step.png
