md-sazzad-eee/ATLAS/07_documentation/figures/carrier_assembly_rear.png

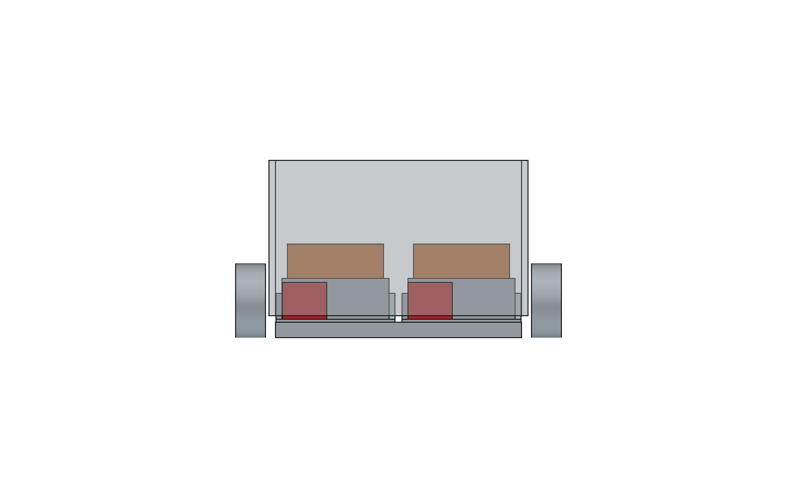
07_documentation/figures/carrier_assembly_rear.png
