md-sazzad-eee/ATLAS/07_documentation/figures/carrier_assembly_trimetric.png

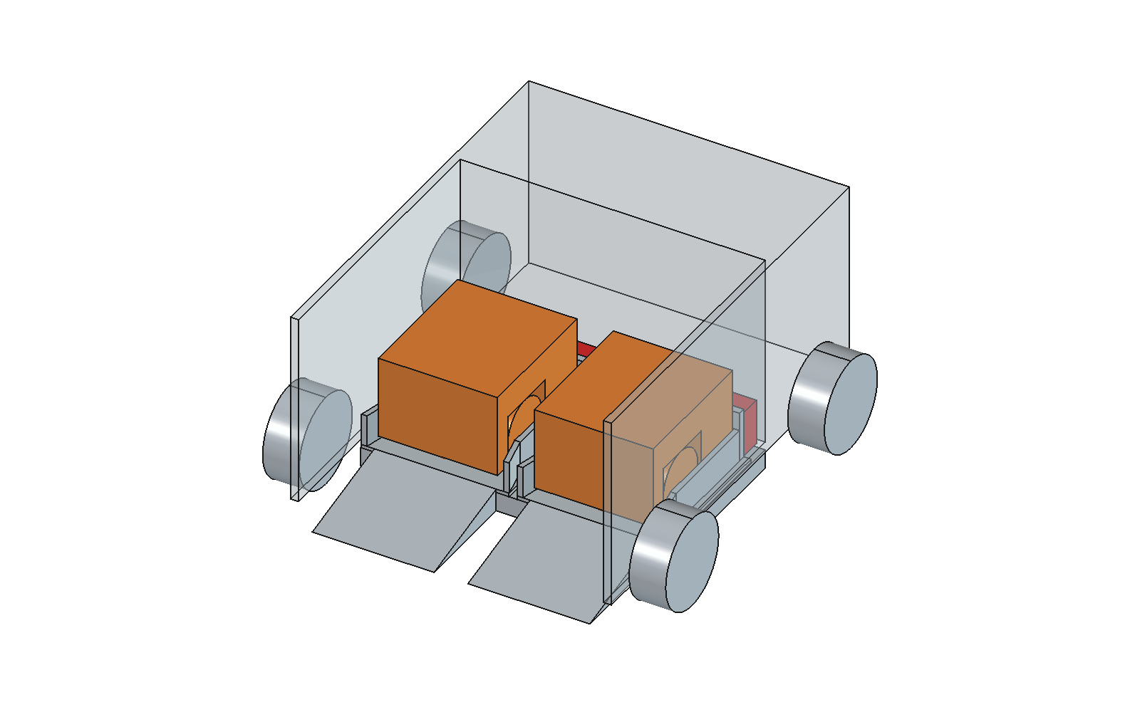
07_documentation/figures/carrier_assembly_trimetric.png
