md-sazzad-eee/ATLAS/05_simulation/matlab/results/contact_heating.png

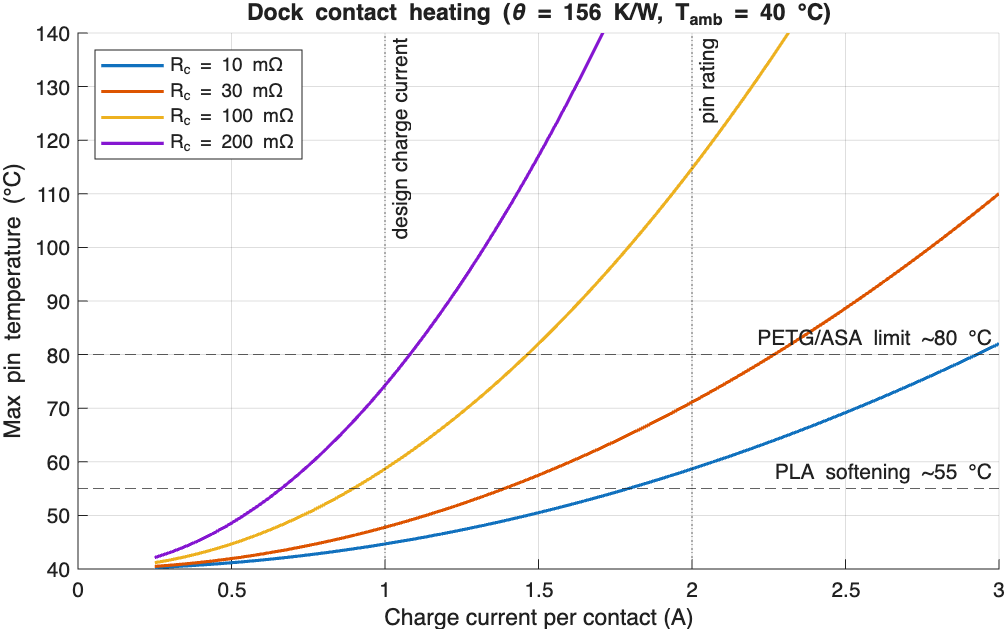
05_simulation/matlab/results/contact_heating.png
