md-sazzad-eee/ATLAS/05_simulation/matlab/results/runtime_vs_capacity.png

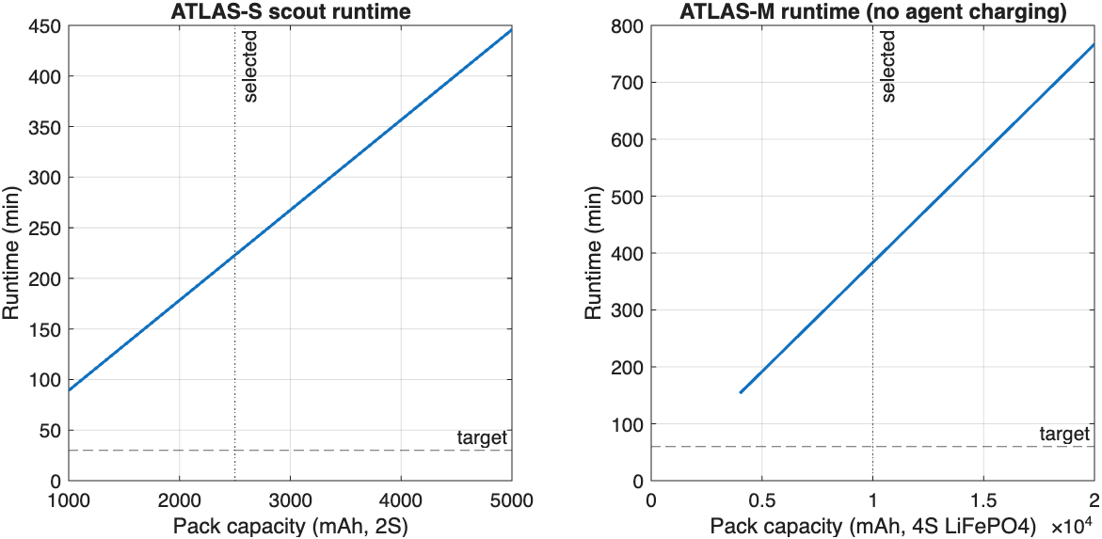
05_simulation/matlab/results/runtime_vs_capacity.png
