md-sazzad-eee/ATLAS/05_simulation/python/results/cc_cv_charger.png

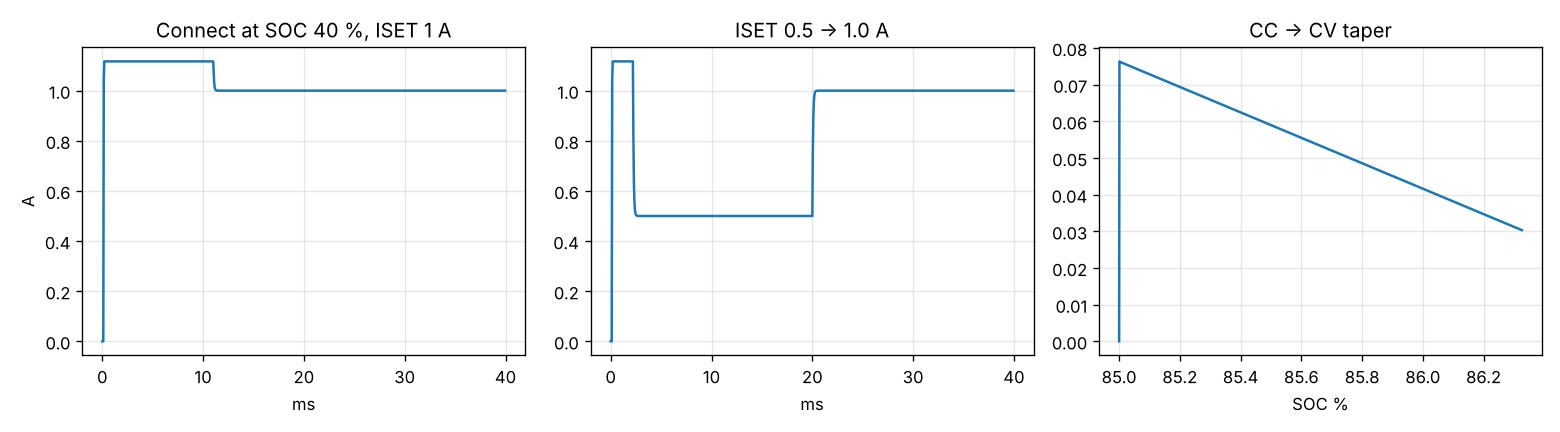
05_simulation/python/results/cc_cv_charger.png
