md-sazzad-eee/ATLAS/05_simulation/python/results/strategy_comparison.png

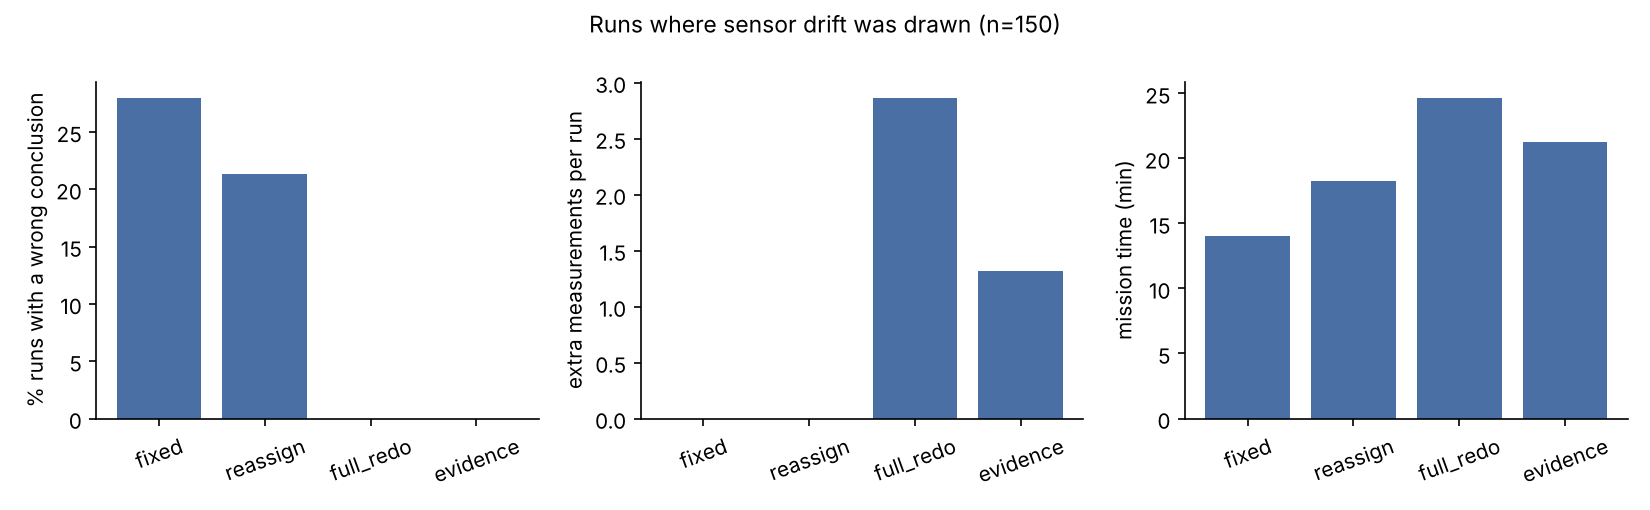
05_simulation/python/results/strategy_comparison.png
