md-sazzad-eee/ATLAS/02_electronics/agent_controller/atlas_agent_ctrl_schematic.pdf

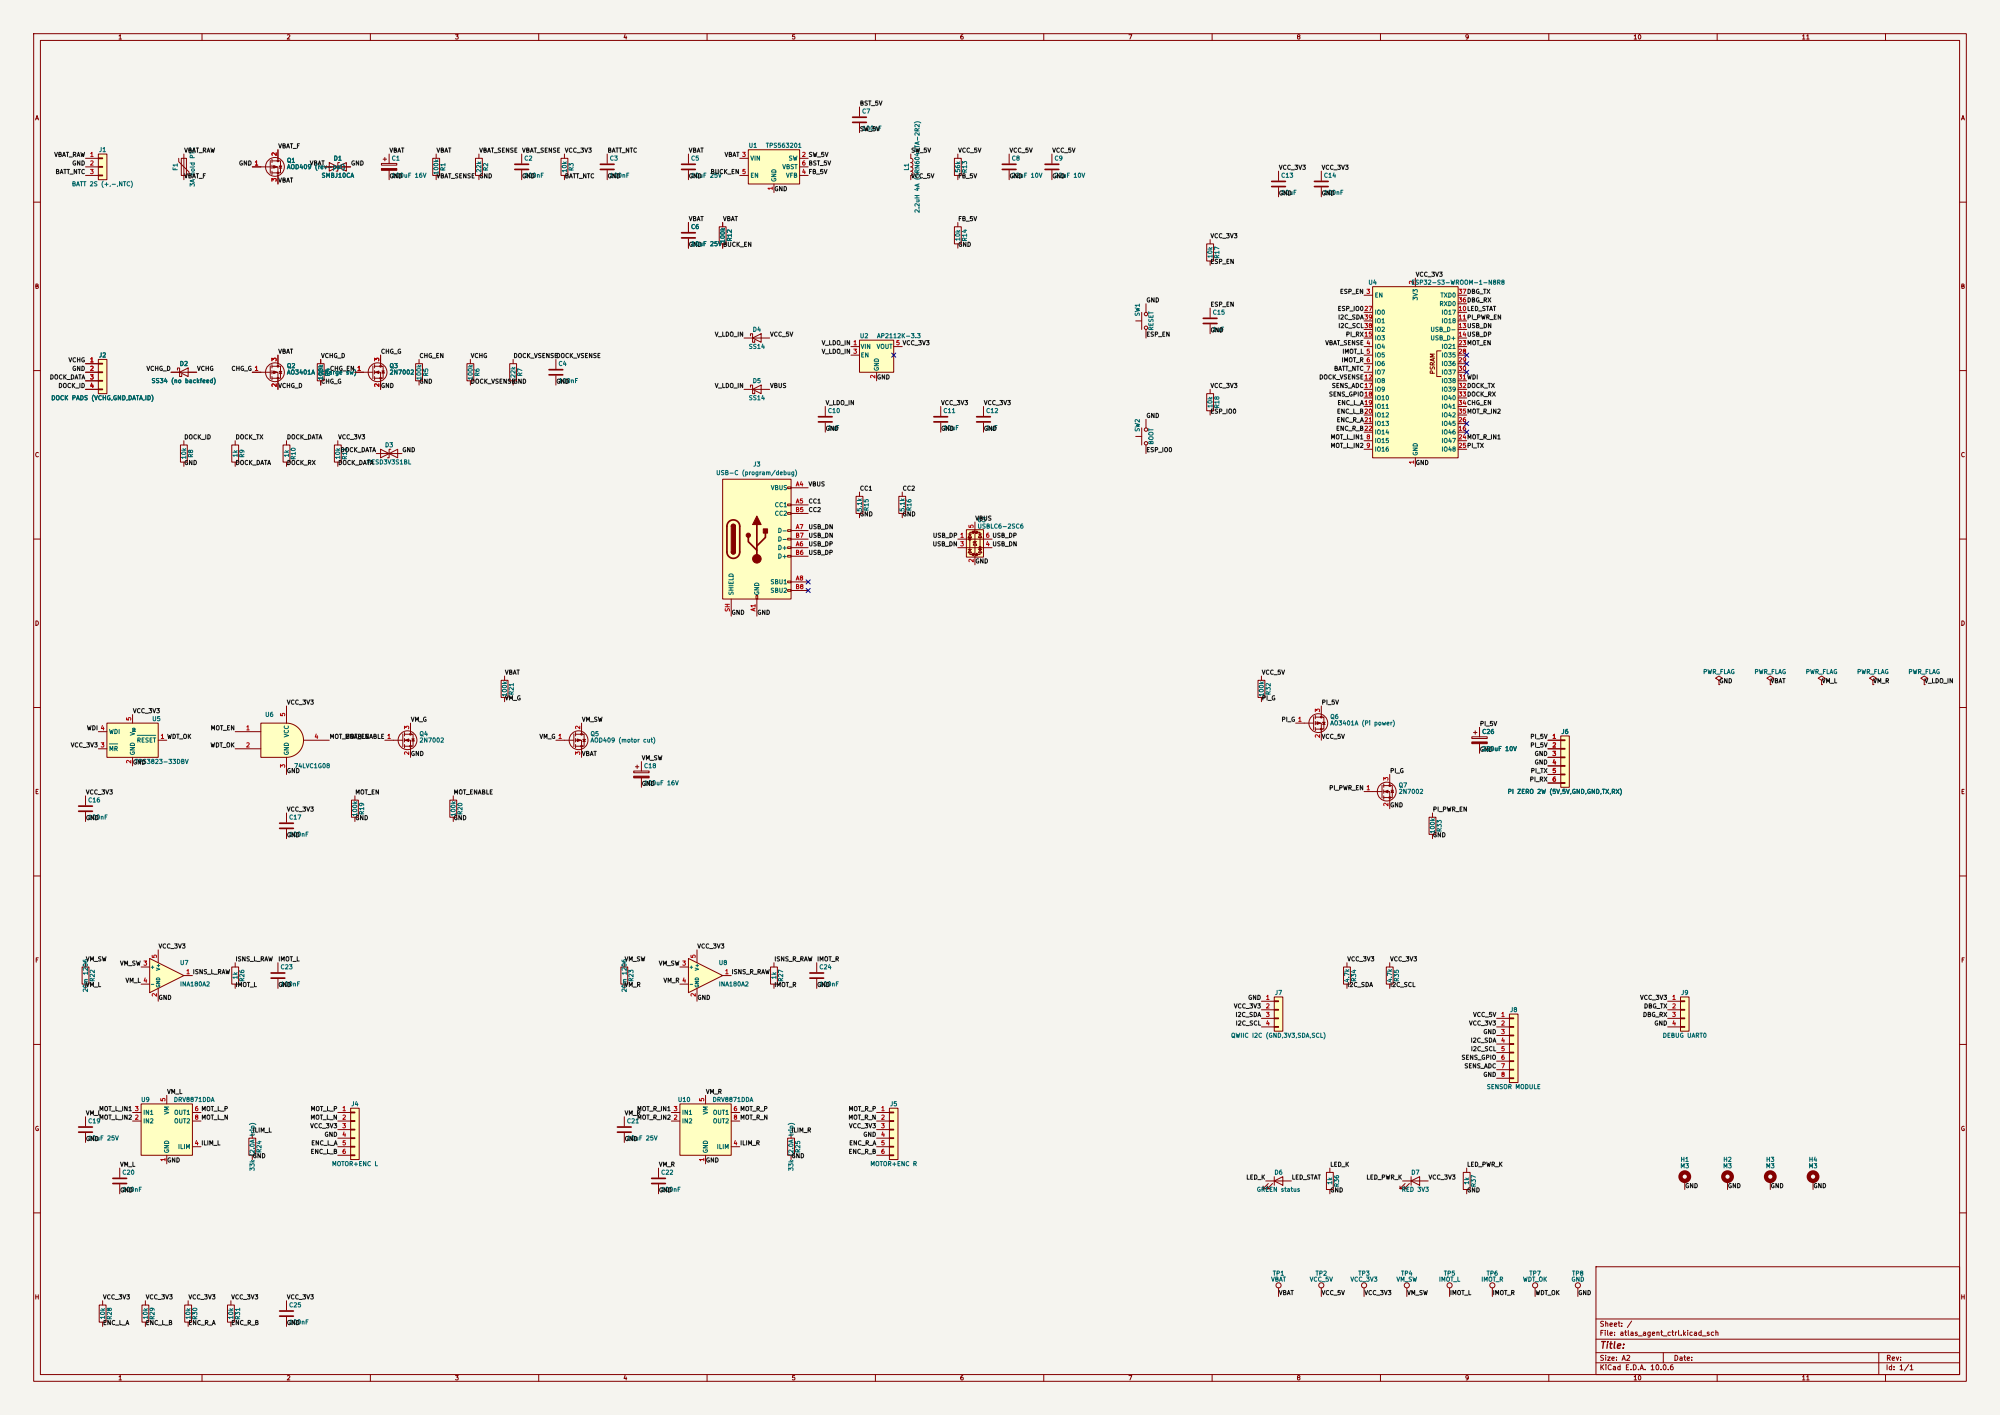
[picture p23: page 1]

2 3 Q1 F1AOD409 (rev-pol) 3A hold PTC
VBAT_RAW

J2 DOCK PADS (VCHG,GND,DATA,ID) 1

J6 PI ZERO 2W (5V,5V,GND,GND,TX,RX)

J6 PI ZERO 2W (5V,5V,GND,GND,TX,RX) 1

Size: A2 | Rev:
KiCad E.D.A. 10.0.6 | Id: 1/1
