md-sazzad-eee/ATLAS/02_electronics/carrier_controller/atlas_carrier_ctrl_schematic.pdf

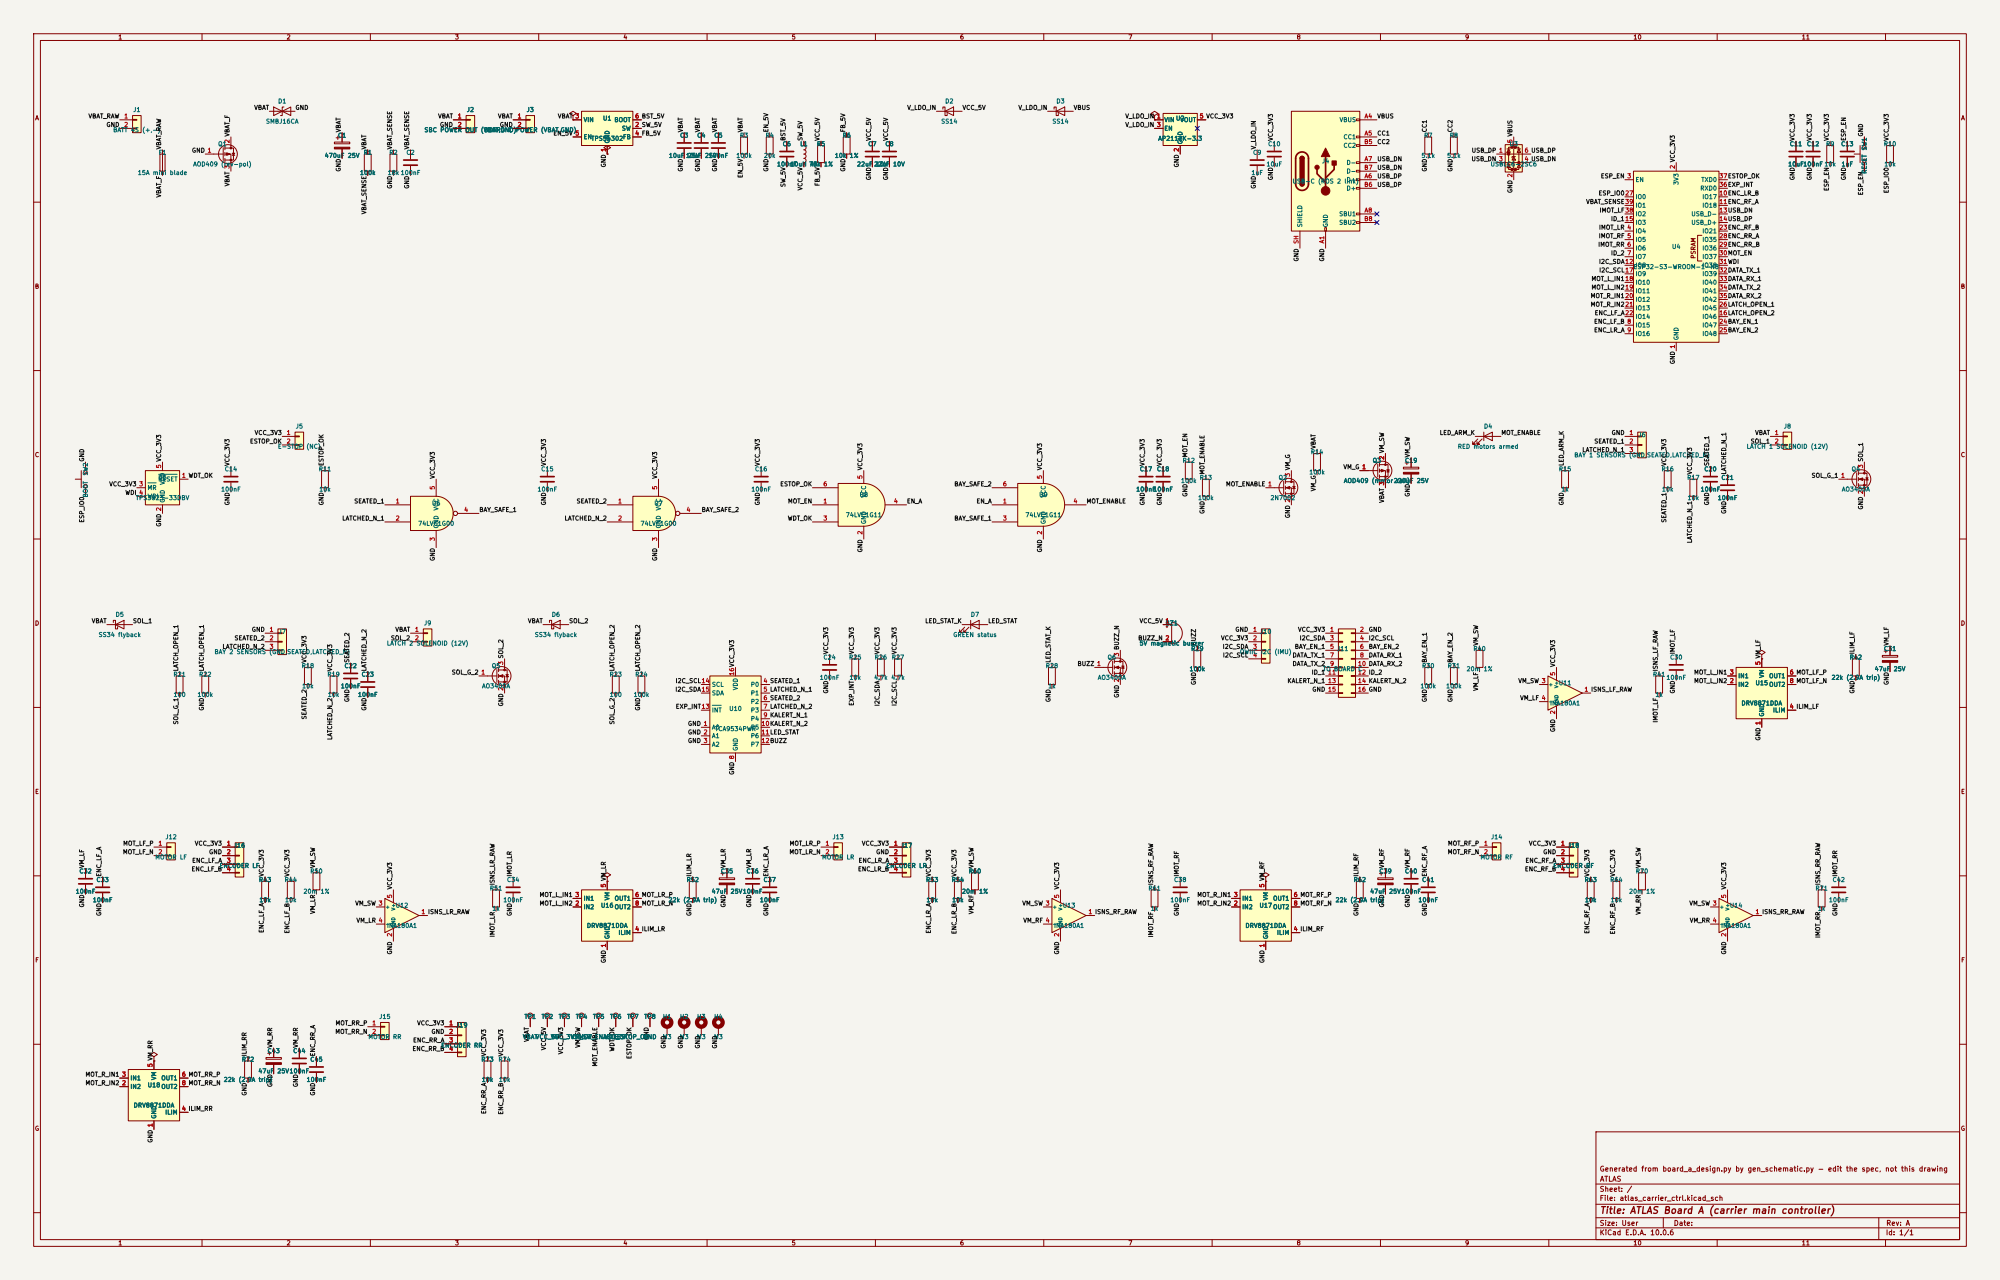
[picture p24: page 1]

J3 BOARD C POWER (VBAT,GND) 1

J6 BAY 1 SENSORS (GND,SEATED,LATCHED_N) 1

J7 BAY 2 SENSORS (GND,SEATED,LATCHED_N) R11

Generated from board_a_design.py by gen_schematic.py - edit the spec, not this drawing
ATLAS
Sheet: /
File: atlas_carrier_ctrl.kicad_sch
Title: ATLAS Board A (carrier main controller)

Size: User | Rev: A
KiCad E.D.A. 10.0.6 | Id: 1/1
