md-sazzad-eee/ATLAS/02_electronics/dock_charger/atlas_dock_charger_schematic.pdf

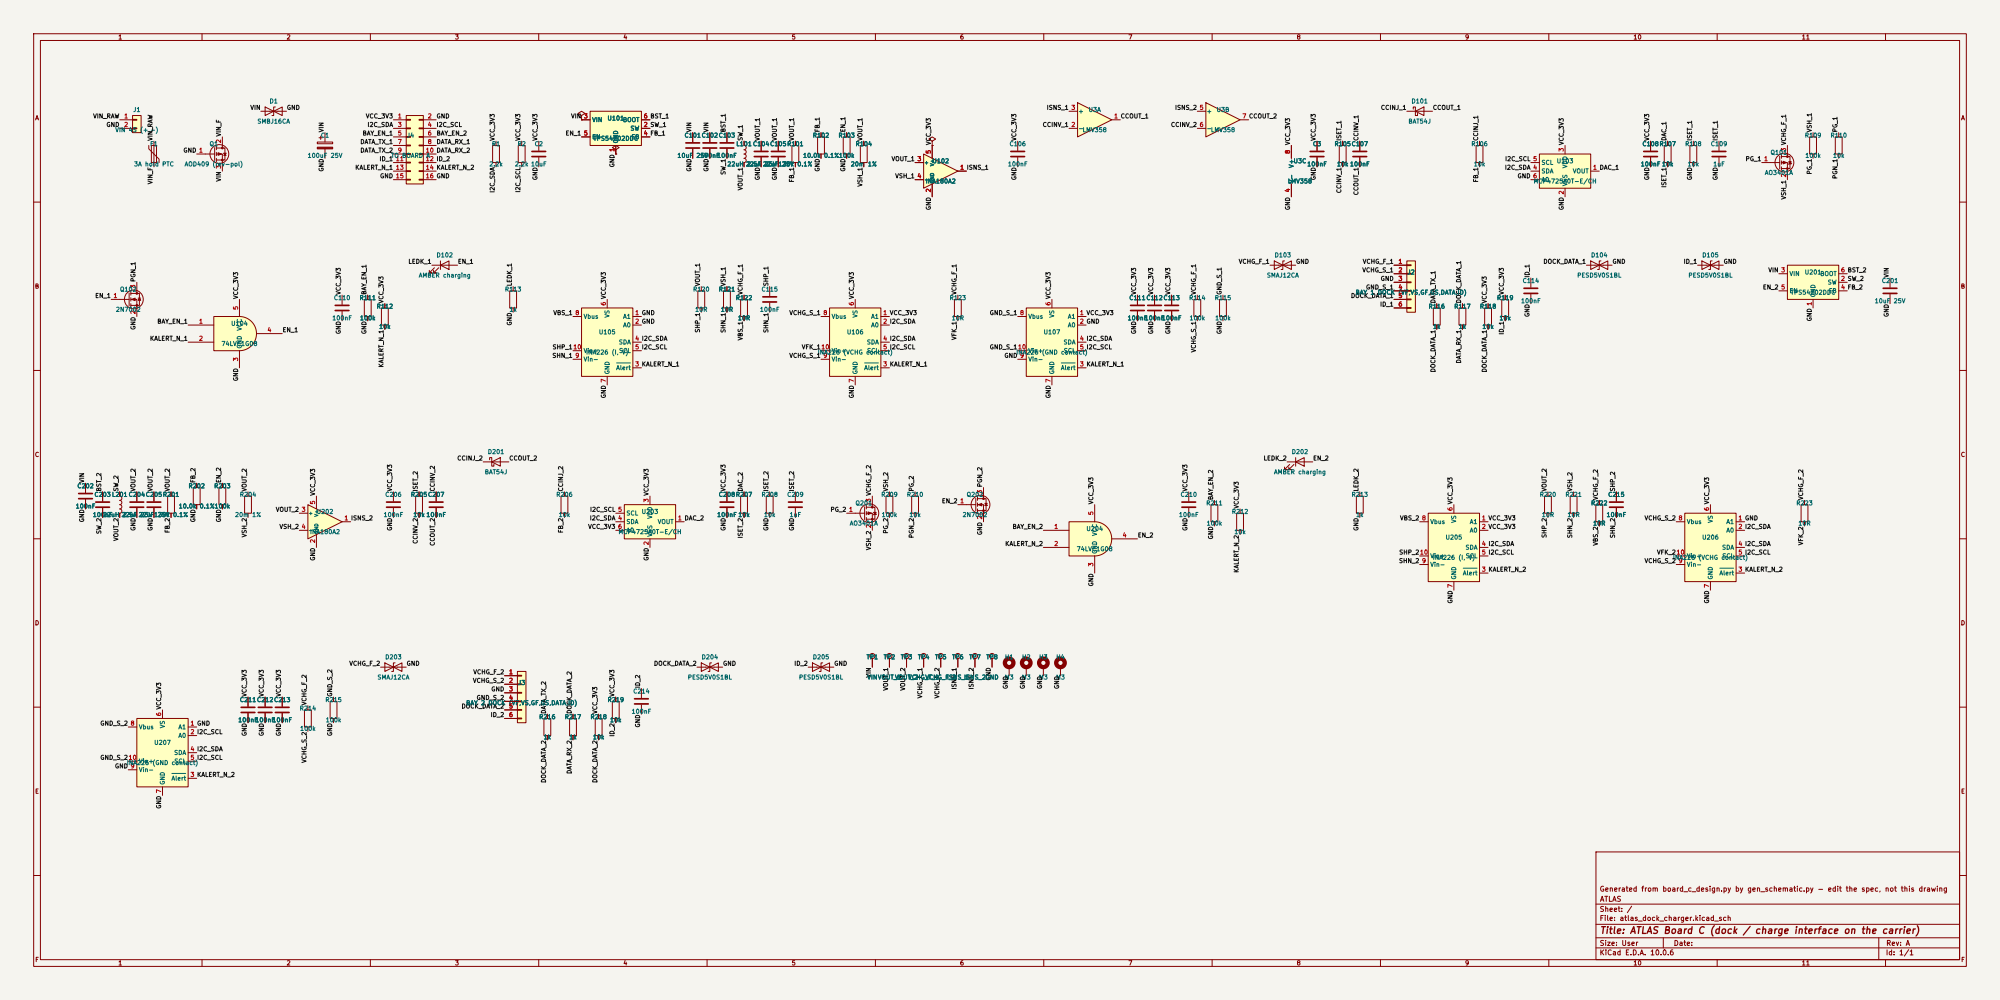
[picture p25: page 1]

J2 BAY 1 DOCK (VF,VS,GF,GS,DATA,ID) 1

J2 BAY 1 DOCK (VF,VS,GF,GS,DATA,ID) R214

J3 BAY 2 DOCK (VF,VS,GF,GS,DATA,ID) 1
J3 BAY 2 DOCK (VF,VS,GF,GS,DATA,ID) R217

Generated from board_c_design.py by gen_schematic.py - edit the spec, not this drawing
ATLAS
Sheet: /
File: atlas_dock_charger.kicad_sch
Title: ATLAS Board C (dock / charge interface on the carrier)

Size: User | Rev: A | F Date:
KiCad E.D.A. 10.0.6 | Id: 1/1
