md-sazzad-eee/ATLAS/02_electronics/carrier_controller/atlas_carrier_ctrl.kicad_pcb

## KiCad design 02_electronics/carrier_controller/atlas_carrier_ctrl.kicad_pcb (2026-10-15)

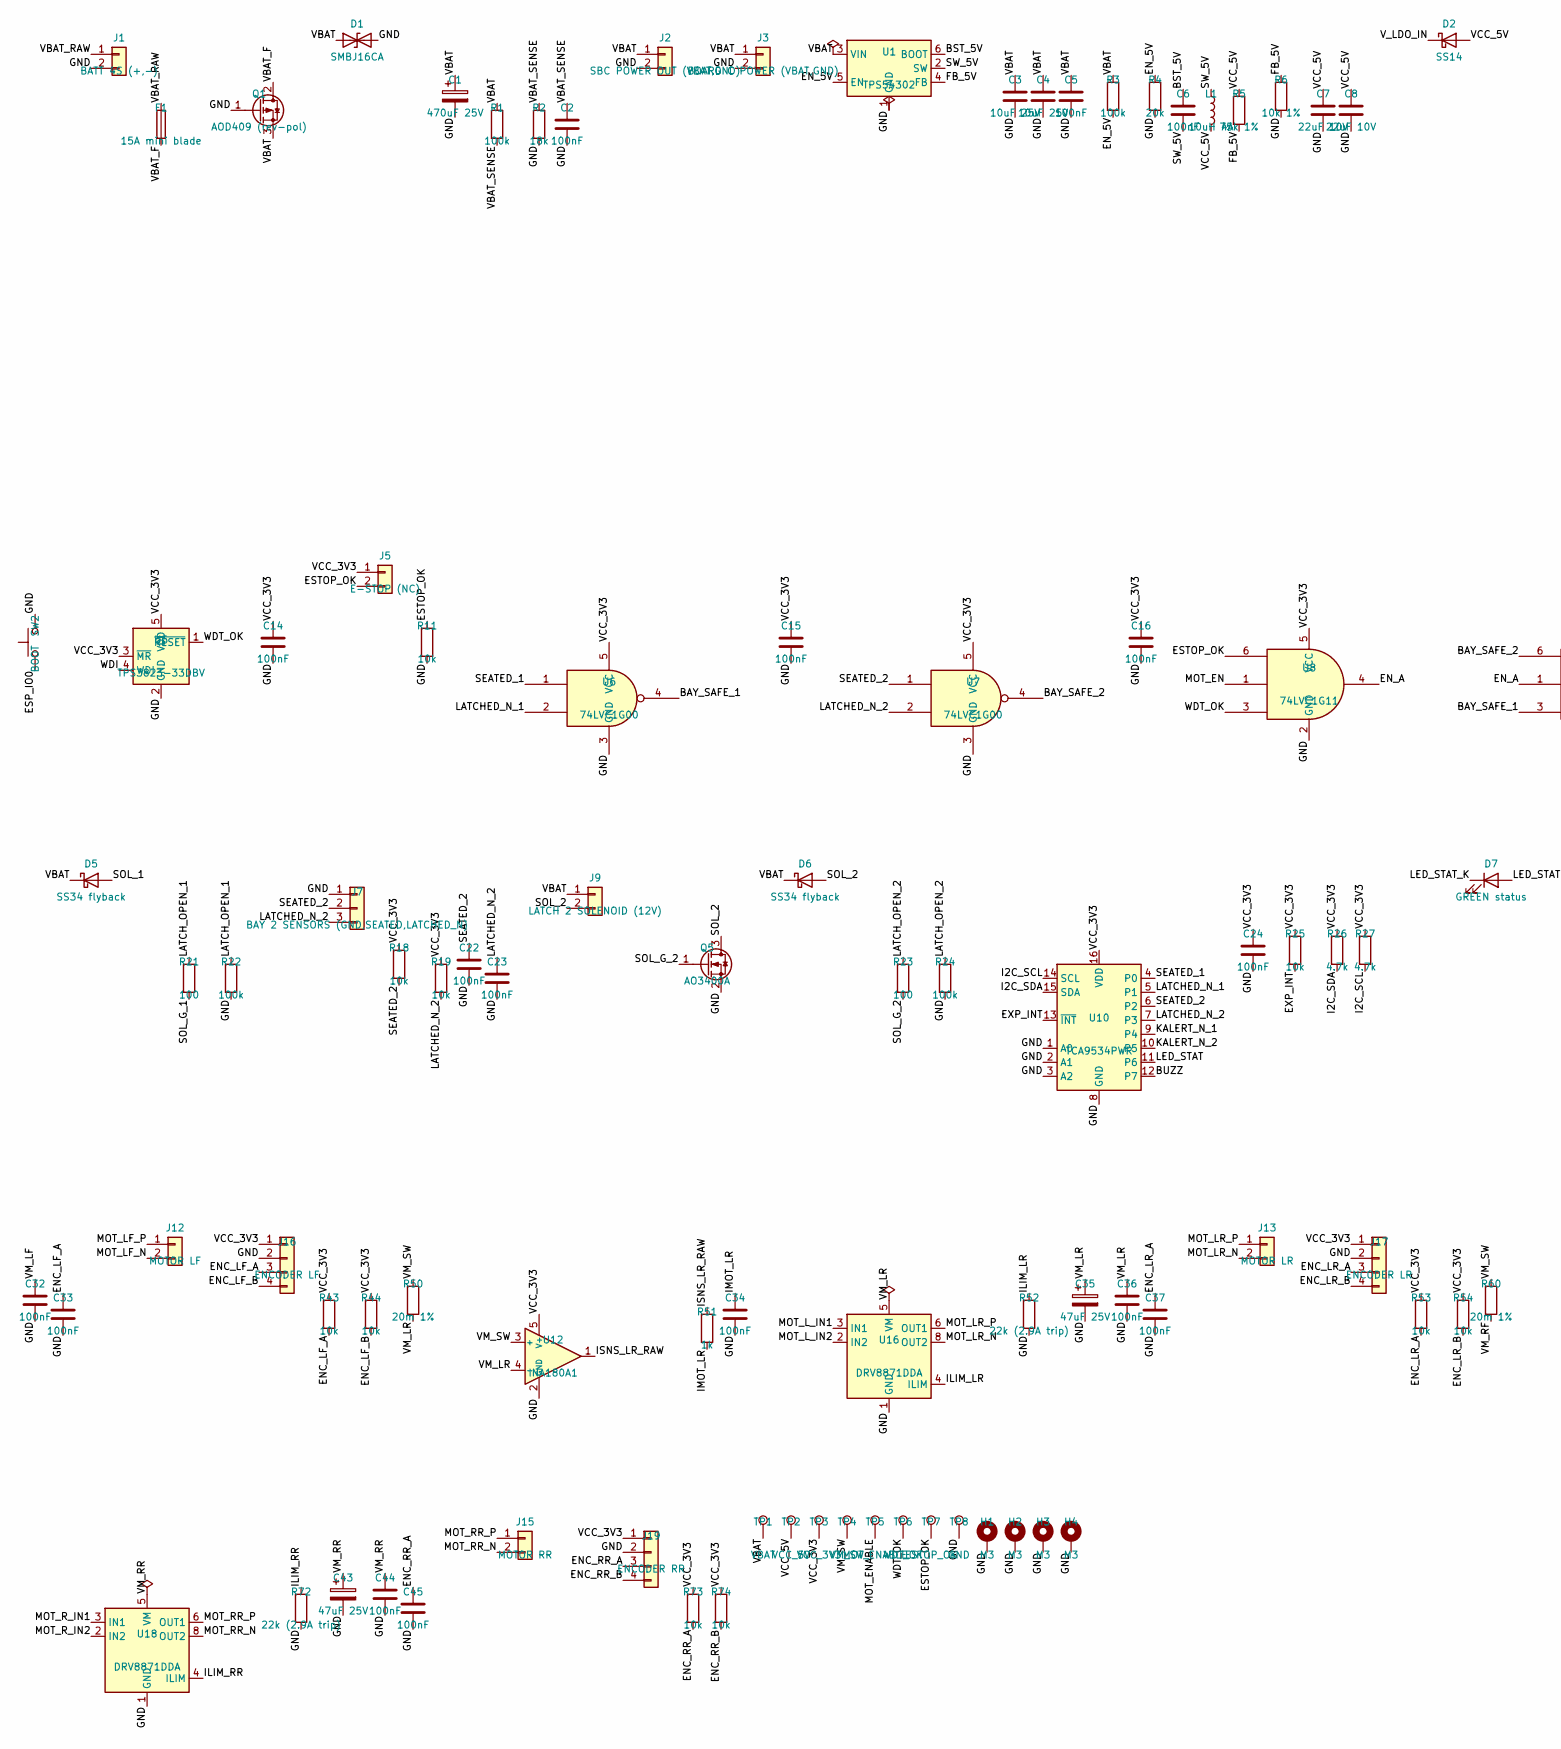
[picture p26: schematic atlas_carrier_ctrl.kicad_sch, ATLAS Board A (carrier main controller), part in row 1, column 1]

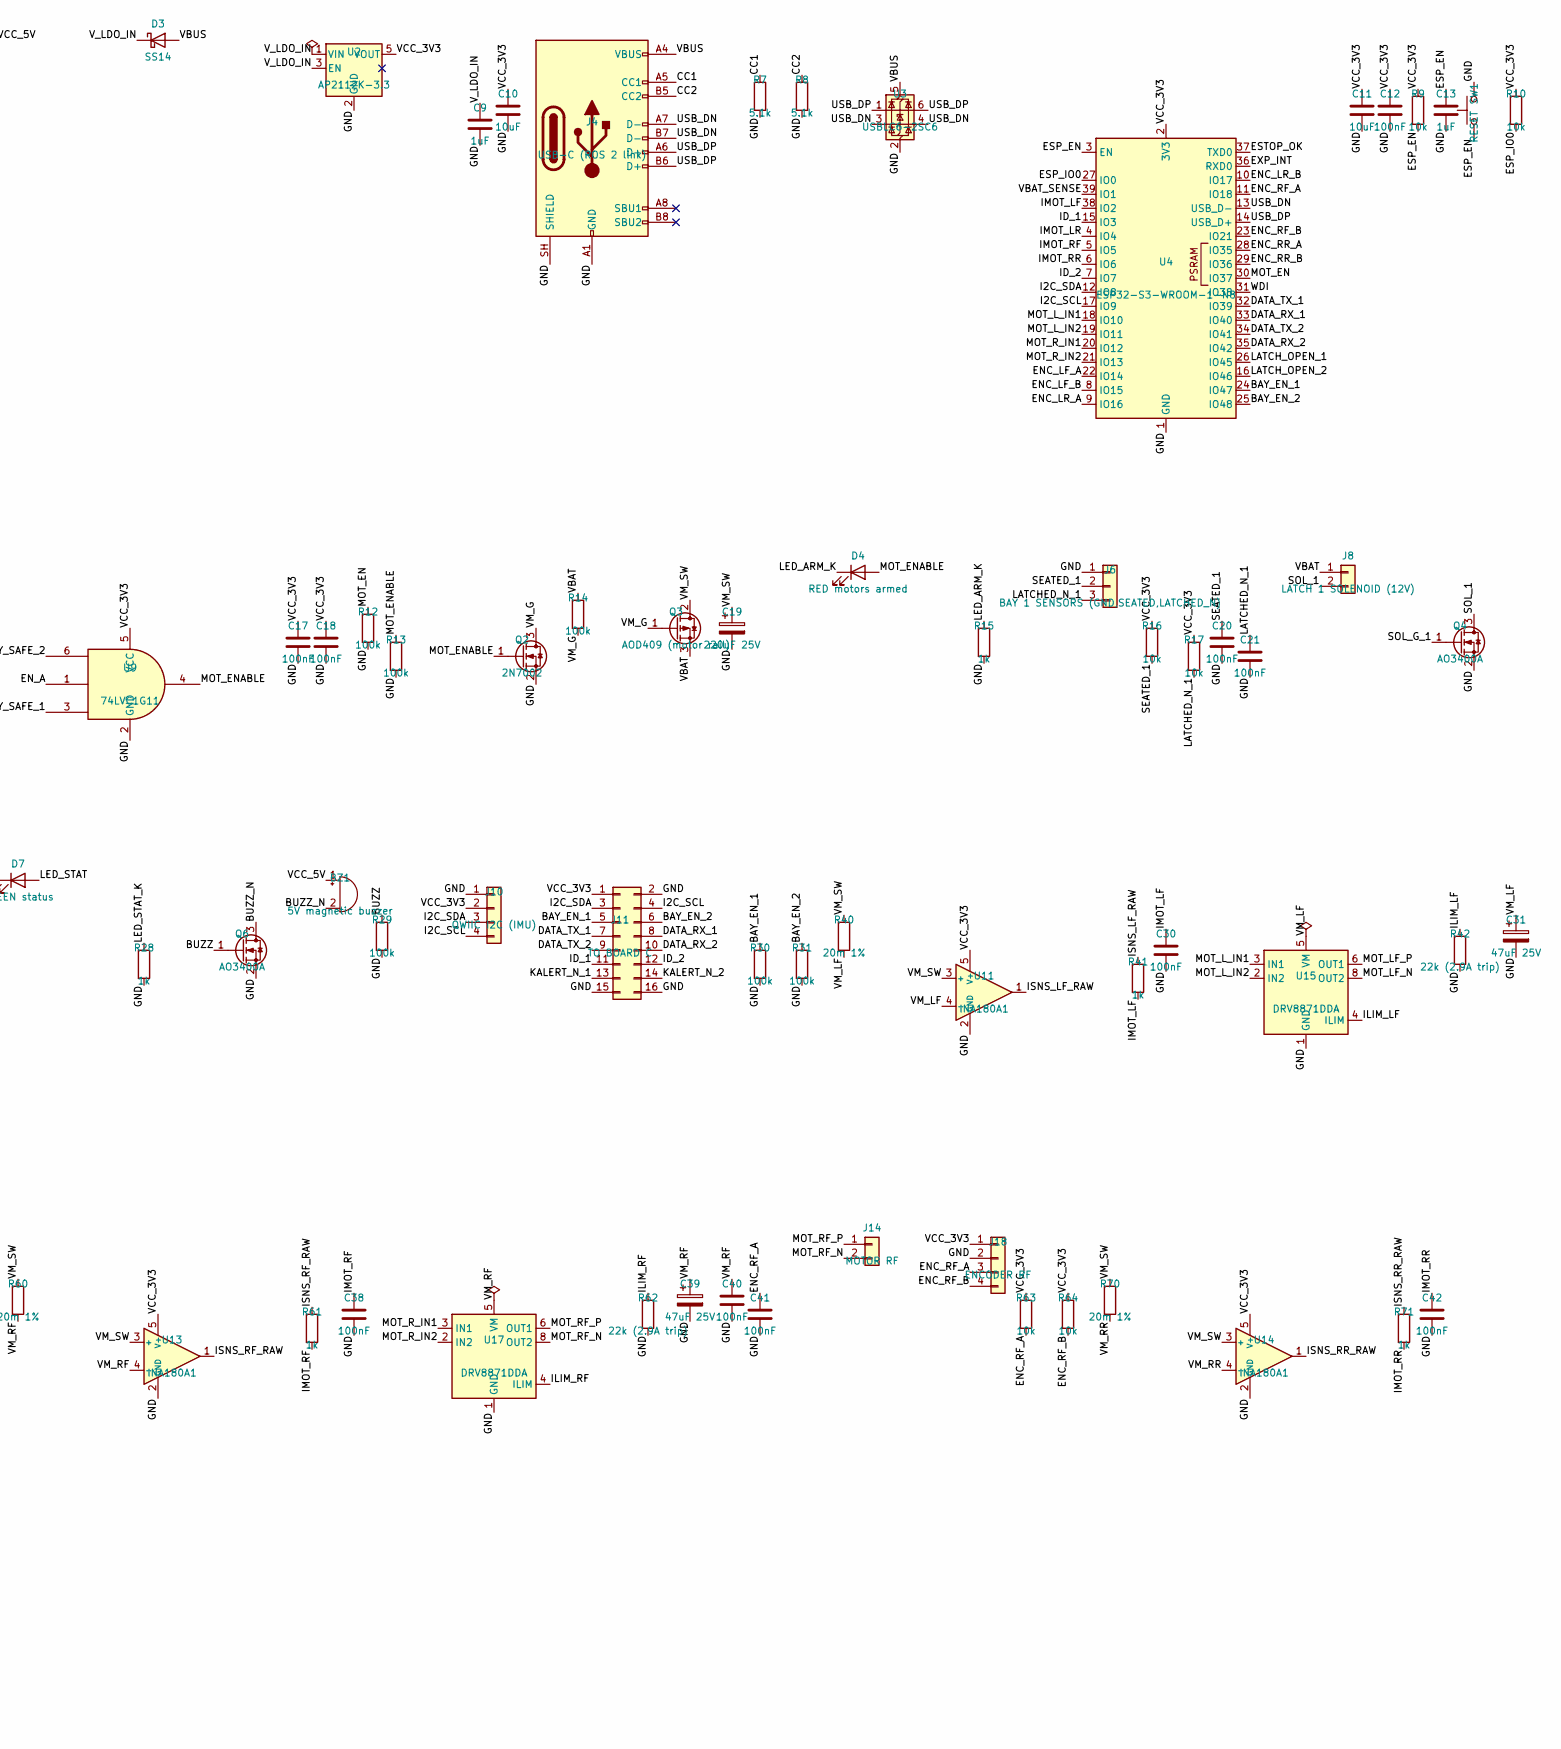
[picture p27: schematic atlas_carrier_ctrl.kicad_sch, ATLAS Board A (carrier main controller), part in row 1, column 2]

Parts:
BZ1: 5V magnetic buzzer; Buzzer_12x9.5RM7.6
C1: 470uF 25V; CP_Elec_10x10.5
C2, C5, C6, C12, C14, C15, C16, C17, C18, C20, C21, C22, C23, C24, C30, C32, C33, C34, C36, C37, C38, C40, C41, C42, C44, C45: 100nF; C_0603_1608Metric
C3, C4: 10uF 25V; C_1206_3216Metric
C7, C8: 22uF 10V; C_1206_3216Metric
C9, C13: 1uF; C_0603_1608Metric
C10, C11: 10uF; C_0805_2012Metric
C19: 220uF 25V; CP_Elec_8x10
C31, C35, C39, C43: 47uF 25V; CP_Elec_6.3x7.7
D1: SMBJ16CA; D_SMB
D2, D3: SS14; D_SMA
D4: RED motors armed; LED_0603_1608Metric
D5, D6: SS34 flyback; D_SMA
D7: GREEN status; LED_0603_1608Metric
F1: 15A mini blade; Fuseholder_Blade_Mini_Keystone_3568
H1, H2, H3, H4: M3; MountingHole_3.2mm_M3_Pad_Via
J1: BATT 4S (+,-); AMASS_XT60PW-M_1x02_P7.20mm_Horizontal
J2: SBC POWER OUT (VBAT,GND); AMASS_XT30PW-M_1x02_P2.50mm_Horizontal
J3: BOARD C POWER (VBAT,GND); AMASS_XT30PW-M_1x02_P2.50mm_Horizontal
J4: USB-C (ROS 2 link); USB_C_Receptacle_GCT_USB4105-xx-A_16P_TopMnt_Horizontal
J5: E-STOP (NC); JST_XH_B2B-XH-A_1x02_P2.50mm_Vertical
J6: BAY 1 SENSORS (GND,SEATED,LATCHED_N); JST_PH_B3B-PH-K_1x03_P2.00mm_Vertical
J7: BAY 2 SENSORS (GND,SEATED,LATCHED_N); JST_PH_B3B-PH-K_1x03_P2.00mm_Vertical
J8: LATCH 1 SOLENOID (12V); JST_VH_B2P-VH_1x02_P3.96mm_Vertical
J9: LATCH 2 SOLENOID (12V); JST_VH_B2P-VH_1x02_P3.96mm_Vertical
J10: QWIIC I2C (IMU); JST_SH_SM04B-SRSS-TB_1x04-1MP_P1.00mm_Horizontal
J11: TO BOARD C; PinHeader_2x08_P2.54mm_Vertical
J12: MOTOR LF; JST_VH_B2P-VH_1x02_P3.96mm_Vertical
J13: MOTOR LR; JST_VH_B2P-VH_1x02_P3.96mm_Vertical
J14: MOTOR RF; JST_VH_B2P-VH_1x02_P3.96mm_Vertical
J15: MOTOR RR; JST_VH_B2P-VH_1x02_P3.96mm_Vertical
J16: ENCODER LF; JST_PH_B4B-PH-K_1x04_P2.00mm_Vertical
J17: ENCODER LR; JST_PH_B4B-PH-K_1x04_P2.00mm_Vertical
J18: ENCODER RF; JST_PH_B4B-PH-K_1x04_P2.00mm_Vertical
J19: ENCODER RR; JST_PH_B4B-PH-K_1x04_P2.00mm_Vertical
L1: 10uH 4A; L_Bourns_SRR1260
Q1: AOD409 (rev-pol); TO-252-2
Q2: 2N7002; SOT-23
Q3: AOD409 (motor rail); TO-252-2
Q4, Q5, Q6: AO3400A; SOT-23
R1, R3, R12, R13, R14, R22, R24, R29, R30, R31: 100k; R_0603_1608Metric
R2: 18k; R_0603_1608Metric
R4: 20k; R_0603_1608Metric
R5: 75k 1%; R_0603_1608Metric
R6: 10k 1%; R_0603_1608Metric
R7, R8: 5.1k; R_0603_1608Metric
R9, R10, R11, R16, R17, R18, R19, R25, R43, R44, R53, R54, R63, R64, R73, R74: 10k; R_0603_1608Metric
R15, R28, R41, R51, R61, R71: 1k; R_0603_1608Metric
R21, R23: 100; R_0603_1608Metric
R26, R27: 4.7k; R_0603_1608Metric
R40, R50, R60, R70: 20m 1%; R_1206_3216Metric
R42, R52, R62, R72: 22k (2.9A trip); R_0603_1608Metric
SW1: RESET; SW_SPST_TL3342
SW2: BOOT; SW_SPST_TL3342
TP1: VBAT; TestPoint_Pad_D1.5mm
TP2: VCC_5V; TestPoint_Pad_D1.5mm
TP3: VCC_3V3; TestPoint_Pad_D1.5mm
TP4: VM_SW; TestPoint_Pad_D1.5mm
TP5: MOT_ENABLE; TestPoint_Pad_D1.5mm
TP6: WDT_OK; TestPoint_Pad_D1.5mm
TP7: ESTOP_OK; TestPoint_Pad_D1.5mm
TP8: GND; TestPoint_Pad_D1.5mm
U1: TPS54302; SOT-23-6
U2: AP2112K-3.3; SOT-23-5
U3: USBLC6-2SC6; SOT-23-6
U4: ESP32-S3-WROOM-1-N8; ESP32-S3-WROOM-1
U5: TPS3823-33DBV; SOT-23-5
U6, U7: 74LVC1G00; SOT-23-5
U8, U9: 74LVC1G11; SOT-23-6
U10: TCA9534PWR; TSSOP-16_4.4x5mm_P0.65mm
U11, U12, U13, U14: INA180A1; SOT-23-5
U15, U16, U17, U18: DRV8871DDA; Texas_HTSOP-8-1EP_3.9x4.9mm_P1.27mm_EP2.95x4.9mm_Mask2.4x3.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

Connections:
/BAY_EN_1: J11.5, R30.1, U4.24 (IO47)
/BAY_EN_2: J11.6, R31.1, U4.25 (IO48)
/BAY_SAFE_1: U6.4, U9.3
/BAY_SAFE_2: U7.4, U9.6
/BST_5V: C6.1, U1.6 (BOOT)
/BUZZ: Q6.1 (G), R29.1, U10.12 (P7)
/BUZZ_N: BZ1.2 (-), Q6.3 (D)
/CC1: J4.A5 (CC1), R7.1
/CC2: J4.B5 (CC2), R8.1
/DATA_RX_1: J11.8, U4.33 (IO40)
/DATA_RX_2: J11.10, U4.35 (IO42)
/DATA_TX_1: J11.7, U4.32 (IO39)
/DATA_TX_2: J11.9, U4.34 (IO41)
/ENC_LF_A: C33.1, J16.3, R43.2, U4.22 (IO14)
/ENC_LF_B: J16.4, R44.2, U4.8 (IO15)
/ENC_LR_A: C37.1, J17.3, R53.2, U4.9 (IO16)
/ENC_LR_B: J17.4, R54.2, U4.10 (IO17)
/ENC_RF_A: C41.1, J18.3, R63.2, U4.11 (IO18)
/ENC_RF_B: J18.4, R64.2, U4.23 (IO21)
/ENC_RR_A: C45.1, J19.3, R73.2, U4.28 (IO35)
/ENC_RR_B: J19.4, R74.2, U4.29 (IO36)
/EN_5V: R3.2, R4.1, U1.5 (EN)
/EN_A: U8.4, U9.1
/ESP_EN: C13.1, R9.2, SW1.1, U4.3 (EN)
/ESP_IO0: R10.2, SW2.1, U4.27 (IO0)
/ESTOP_OK: J5.2, R11.1, TP7.1, U4.37 (TXD0), U8.6
/EXP_INT: R25.2, U4.36 (RXD0), U10.13 (~INT)
/FB_5V: R5.2, R6.1, U1.4 (FB)
/GND: C1.2, C2.2, C3.2, C4.2, C5.2, C7.2, C8.2, C9.2, C10.2, C11.2, C12.2, C13.2, C14.2, C15.2, C16.2, C17.2, C18.2, C19.2, C20.2, C21.2, C22.2, C23.2, C24.2, C30.2, C31.2, C32.2, C33.2, C34.2, C35.2, C36.2, C37.2, C38.2, C39.2, C40.2, C41.2, C42.2, C43.2, C44.2, C45.2, D1.2 (A2), H1.1, H2.1, H3.1, H4.1, J1.2, J2.2, J3.2, J4.A1 (GND), J4.A12 (GND), J4.B1 (GND), J4.B12 (GND), J4.SH (SHIELD), J6.1, J7.1, J10.1, J11.2, J11.15, J11.16, J16.2, J17.2, J18.2, J19.2, Q1.1 (G), Q2.2 (S), Q4.2 (S), Q5.2 (S), Q6.2 (S), R2.2, R4.2, R6.2, R7.2, R8.2, R11.2, R12.2, R13.2, R15.2, R22.2, R24.2, R28.2, R29.2, R30.2, R31.2, R42.2, R52.2, R62.2, R72.2, SW1.2, SW2.2, TP8.1, U1.1 (GND), U2.2 (GND), U3.2 (GND), U4.1 (GND), U4.40 (GND), U4.41 (GND), U5.2 (GND), U6.3 (GND), U7.3 (GND), U8.2 (GND), U9.2 (GND), U10.1 (A0), U10.2 (A1), U10.3 (A2), U10.8 (GND), U11.2 (GND), U12.2 (GND), U13.2 (GND), U14.2 (GND), U15.1 (GND), U15.7 (GND), U15.9 (GND), U16.1 (GND), U16.7 (GND), U16.9 (GND), U17.1 (GND), U17.7 (GND), U17.9 (GND), U18.1 (GND), U18.7 (GND), U18.9 (GND)
/I2C_SCL: J10.4, J11.4, R27.2, U4.17 (IO9), U10.14 (SCL)
/I2C_SDA: J10.3, J11.3, R26.2, U4.12 (IO8), U10.15 (SDA)
/ID_1: J11.11, U4.15 (IO3)
/ID_2: J11.12, U4.7 (IO7)
/ILIM_LF: R42.1, U15.4 (ILIM)
/ILIM_LR: R52.1, U16.4 (ILIM)
/ILIM_RF: R62.1, U17.4 (ILIM)
/ILIM_RR: R72.1, U18.4 (ILIM)
/IMOT_LF: C30.1, R41.2, U4.38 (IO2)
/IMOT_LR: C34.1, R51.2, U4.4 (IO4)
/IMOT_RF: C38.1, R61.2, U4.5 (IO5)
/IMOT_RR: C42.1, R71.2, U4.6 (IO6)
/ISNS_LF_RAW: R41.1, U11.1
/ISNS_LR_RAW: R51.1, U12.1
/ISNS_RF_RAW: R61.1, U13.1
/ISNS_RR_RAW: R71.1, U14.1
/KALERT_N_1: J11.13, U10.9 (P4)
/KALERT_N_2: J11.14, U10.10 (P5)
/LATCHED_N_1: C21.1, J6.3, R17.2, U6.2, U10.5 (P1)
/LATCHED_N_2: C23.1, J7.3, R19.2, U7.2, U10.7 (P3)
/LATCH_OPEN_1: R21.1, R22.1, U4.26 (IO45)
/LATCH_OPEN_2: R23.1, R24.1, U4.16 (IO46)
/LED_ARM_K: D4.1 (K), R15.1
/LED_STAT: D7.2 (A), U10.11 (P6)
/LED_STAT_K: D7.1 (K), R28.1
/MOT_EN: R12.1, U4.30 (IO37), U8.1
/MOT_ENABLE: D4.2 (A), Q2.1 (G), R13.1, TP5.1, U9.4
/MOT_LF_N: J12.2, U15.8 (OUT2)
/MOT_LF_P: J12.1, U15.6 (OUT1)
/MOT_LR_N: J13.2, U16.8 (OUT2)
/MOT_LR_P: J13.1, U16.6 (OUT1)
/MOT_L_IN1: U4.18 (IO10), U15.3 (IN1), U16.3 (IN1)
/MOT_L_IN2: U4.19 (IO11), U15.2 (IN2), U16.2 (IN2)
/MOT_RF_N: J14.2, U17.8 (OUT2)
/MOT_RF_P: J14.1, U17.6 (OUT1)
/MOT_RR_N: J15.2, U18.8 (OUT2)
/MOT_RR_P: J15.1, U18.6 (OUT1)
/MOT_R_IN1: U4.20 (IO12), U17.3 (IN1), U18.3 (IN1)
/MOT_R_IN2: U4.21 (IO13), U17.2 (IN2), U18.2 (IN2)
/SEATED_1: C20.1, J6.2, R16.2, U6.1, U10.4 (P0)
/SEATED_2: C22.1, J7.2, R18.2, U7.1, U10.6 (P2)
/SOL_1: D5.2 (A), J8.2, Q4.3 (D)
/SOL_2: D6.2 (A), J9.2, Q5.3 (D)
/SOL_G_1: Q4.1 (G), R21.2
/SOL_G_2: Q5.1 (G), R23.2
/SW_5V: C6.2, L1.1, U1.2 (SW)
/USB_DN: J4.A7 (D-), J4.B7 (D-), U3.3 (I/O2), U3.4 (I/O2), U4.13 (USB_D-)
/USB_DP: J4.A6 (D+), J4.B6 (D+), U3.1 (I/O1), U3.6 (I/O1), U4.14 (USB_D+)
/VBAT: C1.1, C3.1, C4.1, C5.1, D1.1 (A1), D5.1 (K), D6.1 (K), J2.1, J3.1, J8.1, J9.1, Q1.3 (S), Q3.3 (S), R1.1, R3.1, R14.1, TP1.1, U1.3 (VIN)
/VBAT_F: F1.2, Q1.2 (D)
/VBAT_RAW: F1.1, J1.1
/VBAT_SENSE: C2.1, R1.2, R2.1, U4.39 (IO1)
/VBUS: D3.2 (A), J4.A4 (VBUS), J4.A9 (VBUS), J4.B4 (VBUS), J4.B9 (VBUS), U3.5 (VBUS)
/VCC_3V3: C10.1, C11.1, C12.1, C14.1, C15.1, C16.1, C17.1, C18.1, C24.1, J5.1, J10.2, J11.1, J16.1, J17.1, J18.1, J19.1, R9.1, R10.1, R16.1, R17.1, R18.1, R19.1, R25.1, R26.1, R27.1, R43.1, R44.1, R53.1, R54.1, R63.1, R64.1, R73.1, R74.1, TP3.1, U2.5 (VOUT), U4.2 (3V3), U5.3 (~MR), U5.5 (VDD), U6.5 (VCC), U7.5 (VCC), U8.5 (VCC), U9.5 (VCC), U10.16 (VDD), U11.5 (V+), U12.5 (V+), U13.5 (V+), U14.5 (V+)
/VCC_5V: BZ1.1 (+), C7.1, C8.1, D2.2 (A), L1.2, R5.1, TP2.1
/VM_G: Q2.3 (D), Q3.1 (G), R14.2
/VM_LF: C31.1, C32.1, R40.2, U11.4 (-), U15.5 (VM)
/VM_LR: C35.1, C36.1, R50.2, U12.4 (-), U16.5 (VM)
/VM_RF: C39.1, C40.1, R60.2, U13.4 (-), U17.5 (VM)
/VM_RR: C43.1, C44.1, R70.2, U14.4 (-), U18.5 (VM)
/VM_SW: C19.1, Q3.2 (D), R40.1, R50.1, R60.1, R70.1, TP4.1, U11.3 (+), U12.3 (+), U13.3 (+), U14.3 (+)
/V_LDO_IN: C9.1, D2.1 (K), D3.1 (K), U2.1 (VIN), U2.3 (EN)
/WDI: U4.31 (IO38), U5.4 (WDI)
/WDT_OK: TP6.1, U5.1 (~RESET), U8.3

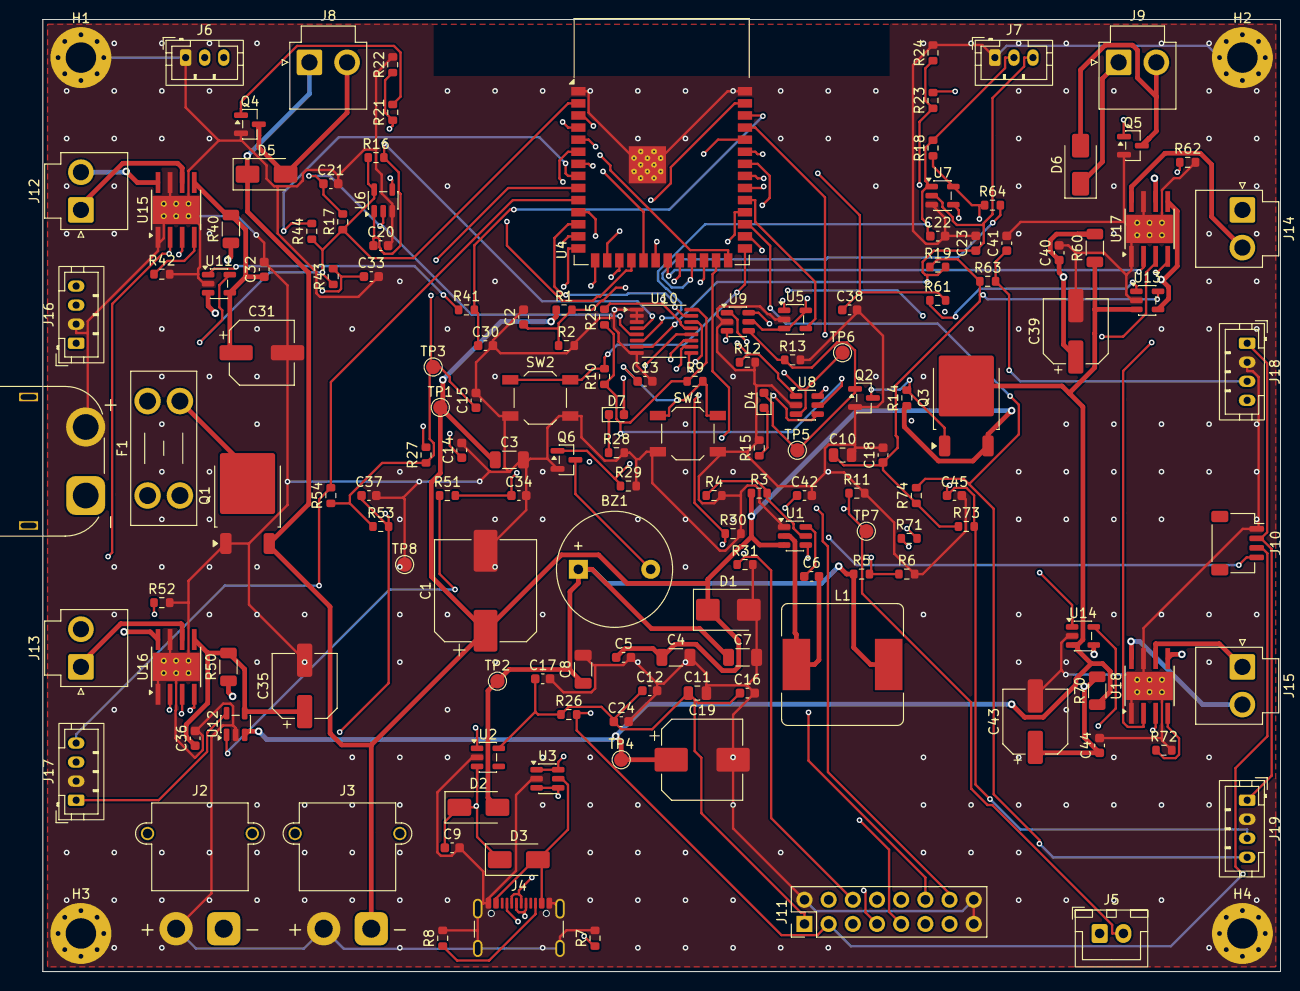
[picture p28: board atlas_carrier_ctrl.kicad_pcb from above]

Board: 4 copper layers, 130.0 x 100.0 mm, 157 parts (0 on the bottom side), 93 nets.
