md-sazzad-eee/ATLAS/02_electronics/agent_controller/atlas_agent_ctrl.kicad_pcb

## KiCad design 02_electronics/agent_controller/atlas_agent_ctrl.kicad_pcb (2026-10-15)

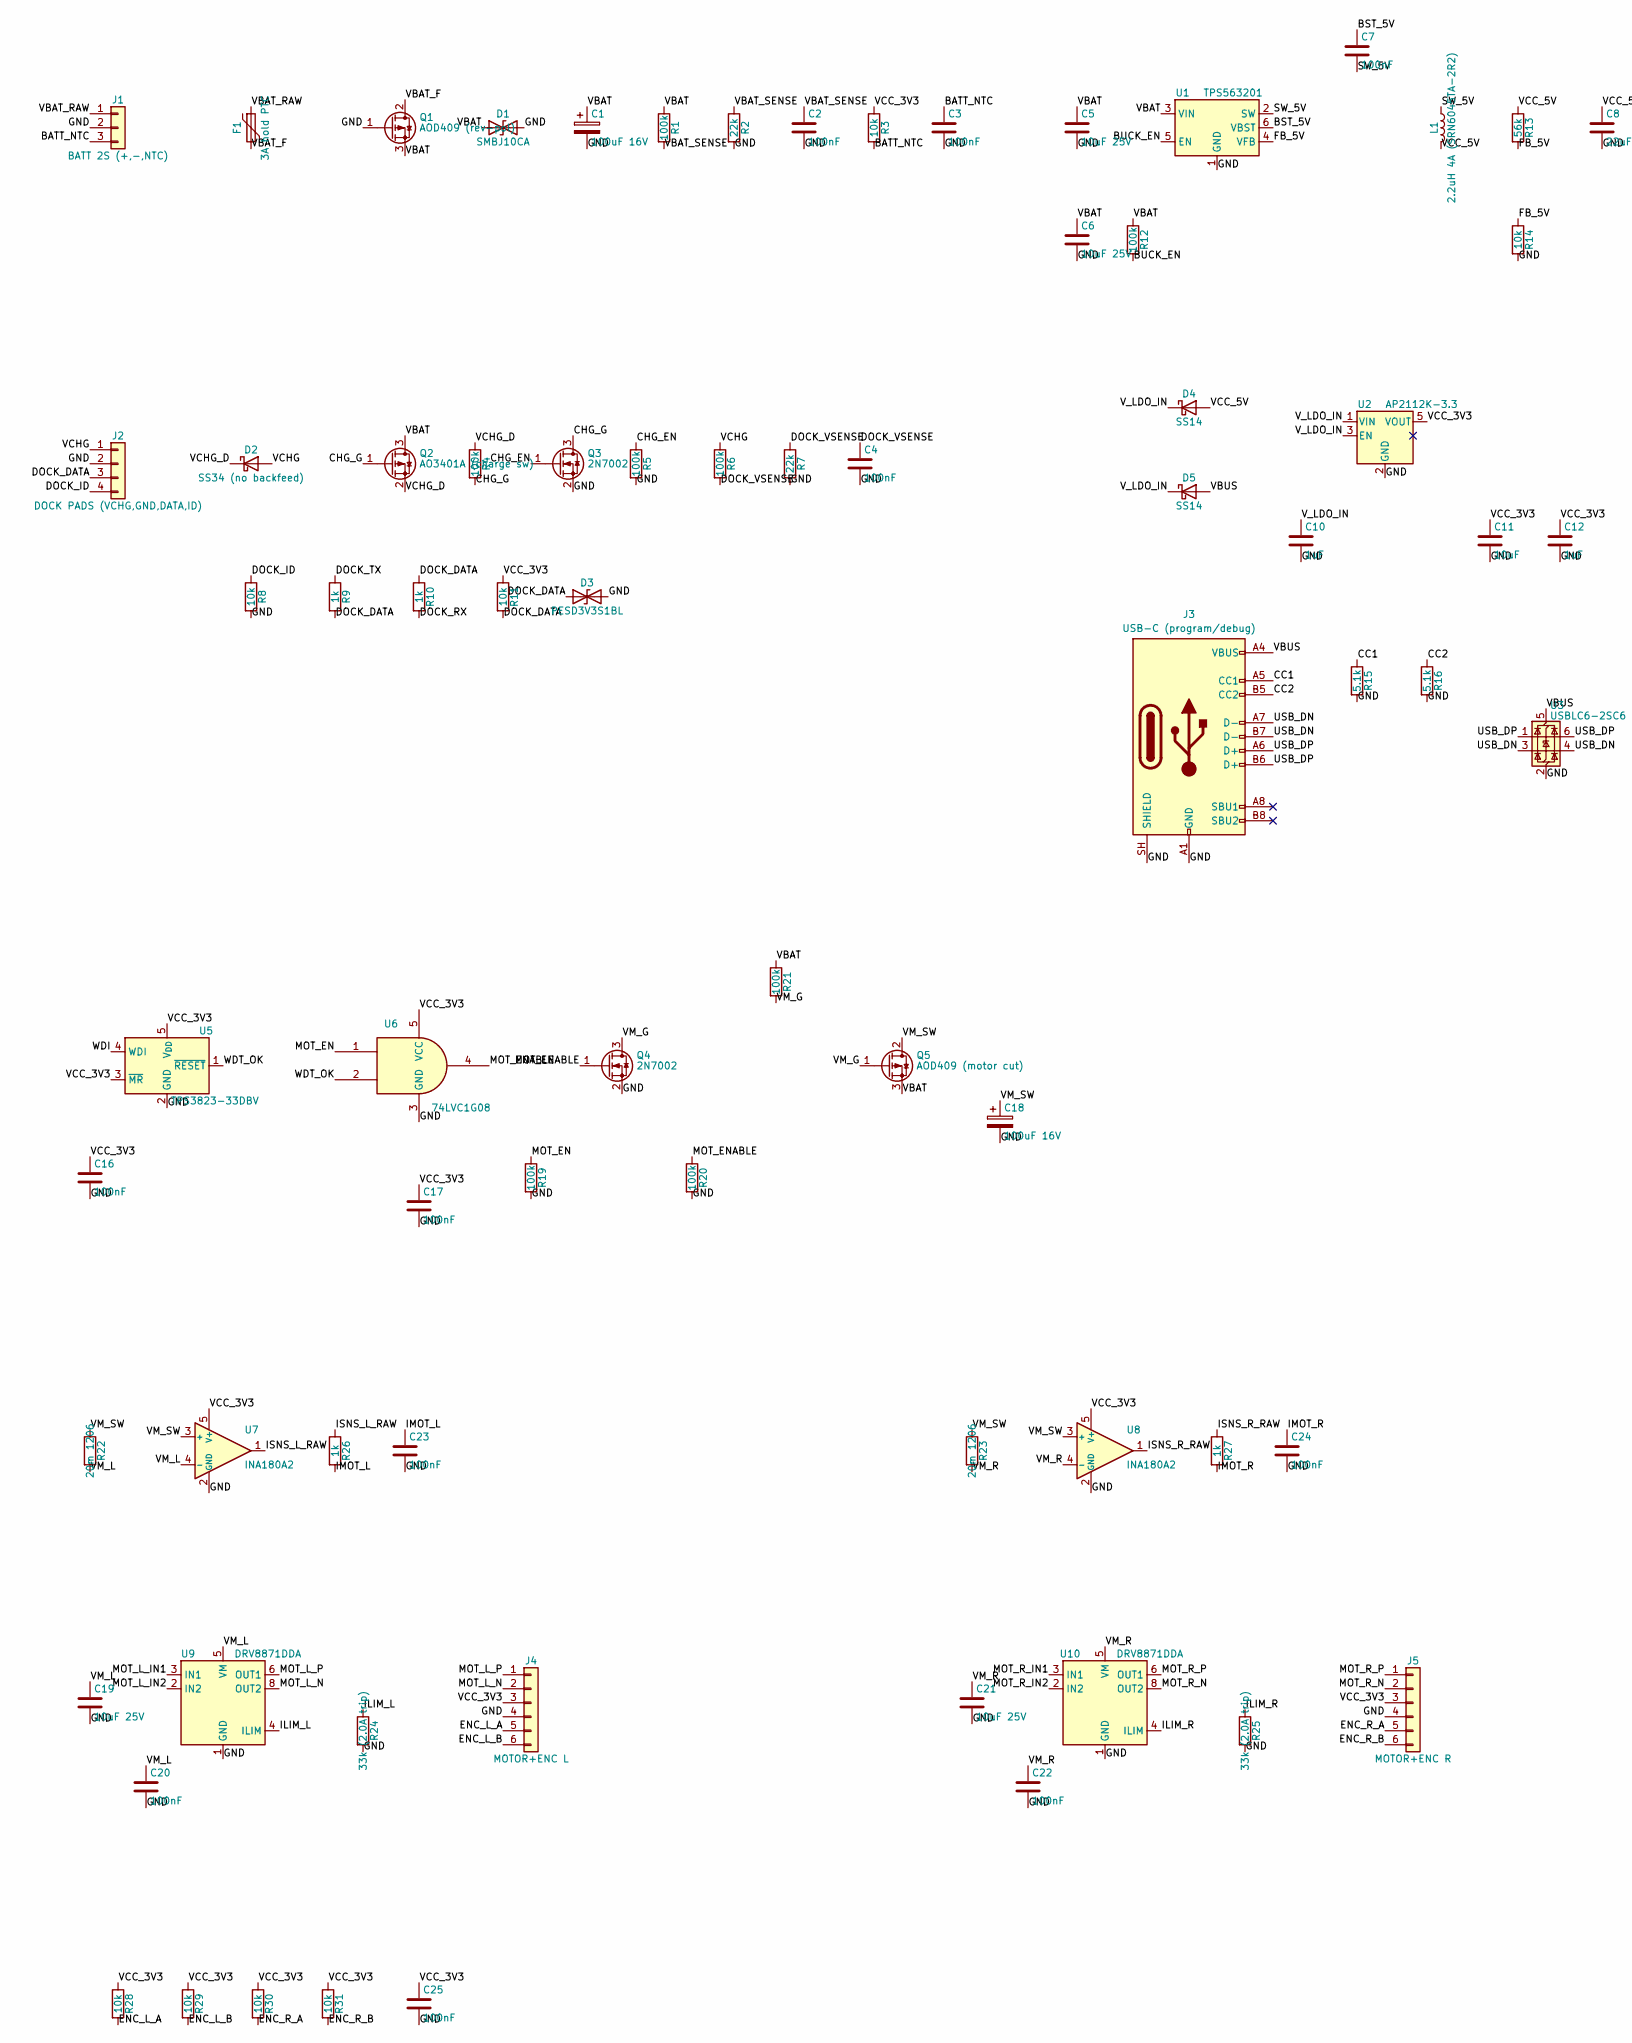
[picture p29: schematic atlas_agent_ctrl.kicad_sch, part in row 1, column 1]

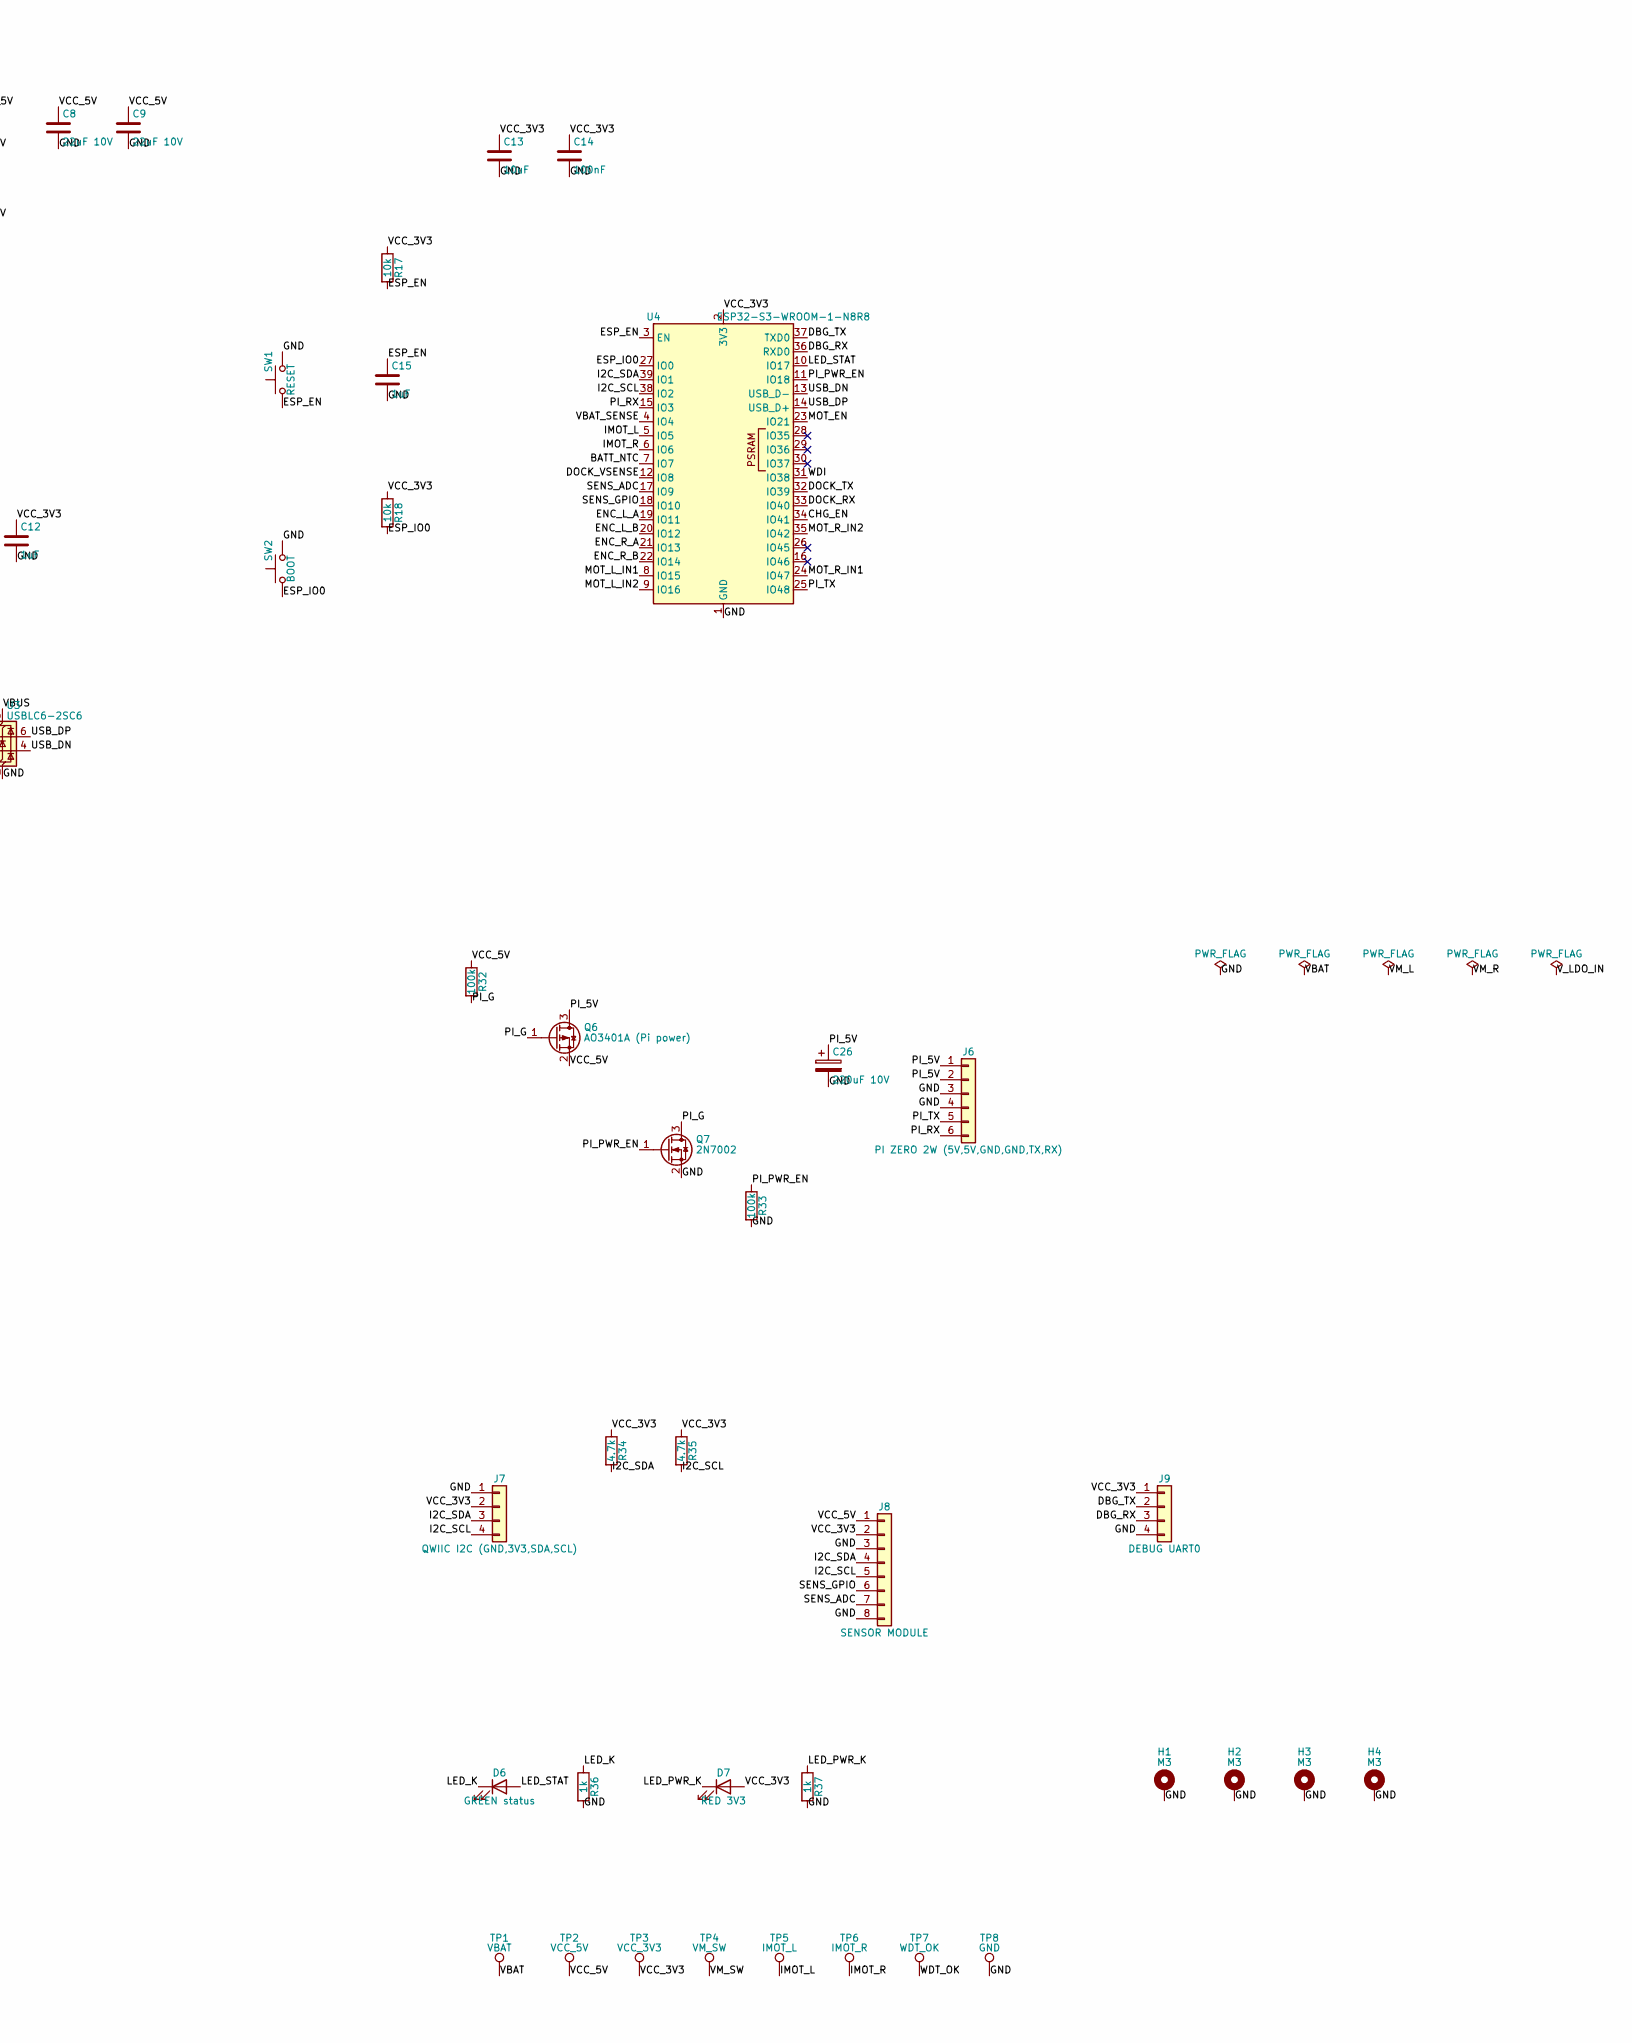
[picture p30: schematic atlas_agent_ctrl.kicad_sch, part in row 1, column 2]

Parts:
C1, C18: 100uF 16V; CP_Elec_6.3x7.7
C2, C3, C4, C7, C14, C16, C17, C20, C22, C23, C24, C25: 100nF; C_0603_1608Metric
C5, C6, C19, C21: 10uF 25V; C_0805_2012Metric
C8, C9: 22uF 10V; C_0805_2012Metric
C10, C12, C15: 1uF; C_0603_1608Metric
C11, C13: 10uF; C_0805_2012Metric
C26: 220uF 10V; CP_Elec_6.3x7.7
D1: SMBJ10CA; D_SMB
D2: SS34 (no backfeed); D_SMA
D3: PESD3V3S1BL; D_SOD-323
D4, D5: SS14; D_SMA
D6: GREEN status; LED_0603_1608Metric
D7: RED 3V3; LED_0603_1608Metric
F1: 3A hold PTC; Fuse_1812_4532Metric
H1, H2, H3, H4: M3; MountingHole_3.2mm_M3_Pad_Via
J1: BATT 2S (+,-,NTC); JST_XH_B3B-XH-A_1x03_P2.50mm_Vertical
J2: DOCK PADS (VCHG,GND,DATA,ID); JST_XH_B4B-XH-A_1x04_P2.50mm_Vertical
J3: USB-C (program/debug); USB_C_Receptacle_GCT_USB4105-xx-A_16P_TopMnt_Horizontal
J4: MOTOR+ENC L; JST_PH_B6B-PH-K_1x06_P2.00mm_Vertical
J5: MOTOR+ENC R; JST_PH_B6B-PH-K_1x06_P2.00mm_Vertical
J6: PI ZERO 2W (5V,5V,GND,GND,TX,RX); JST_GH_SM06B-GHS-TB_1x06-1MP_P1.25mm_Horizontal
J7: QWIIC I2C (GND,3V3,SDA,SCL); JST_SH_SM04B-SRSS-TB_1x04-1MP_P1.00mm_Horizontal
J8: SENSOR MODULE; JST_GH_SM08B-GHS-TB_1x08-1MP_P1.25mm_Horizontal
J9: DEBUG UART0; PinHeader_1x04_P2.54mm_Vertical
L1: 2.2uH 4A (SRN6045TA-2R2); L_Bourns_SRN6045TA
Q1: AOD409 (rev-pol); TO-252-2
Q2: AO3401A (charge sw); SOT-23
Q3, Q4, Q7: 2N7002; SOT-23
Q5: AOD409 (motor cut); TO-252-2
Q6: AO3401A (Pi power); SOT-23
R1, R4, R5, R6, R12, R19, R20, R21, R32, R33: 100k; R_0603_1608Metric
R2, R7: 22k; R_0603_1608Metric
R3, R8, R11, R14, R17, R18, R28, R29, R30, R31: 10k; R_0603_1608Metric
R9, R10, R26, R27, R36, R37: 1k; R_0603_1608Metric
R13: 56k; R_0603_1608Metric
R15, R16: 5.1k; R_0603_1608Metric
R22, R23: 20m 1206; R_1206_3216Metric
R24, R25: 33k (2.0A trip); R_0603_1608Metric
R34, R35: 4.7k; R_0603_1608Metric
SW1: RESET; SW_SPST_TL3342
SW2: BOOT; SW_SPST_TL3342
TP1: VBAT; TestPoint_Pad_D1.5mm
TP2: VCC_5V; TestPoint_Pad_D1.5mm
TP3: VCC_3V3; TestPoint_Pad_D1.5mm
TP4: VM_SW; TestPoint_Pad_D1.5mm
TP5: IMOT_L; TestPoint_Pad_D1.5mm
TP6: IMOT_R; TestPoint_Pad_D1.5mm
TP7: WDT_OK; TestPoint_Pad_D1.5mm
TP8: GND; TestPoint_Pad_D1.5mm
U1: TPS563201; SOT-23-6
U2: AP2112K-3.3; SOT-23-5
U3: USBLC6-2SC6; SOT-23-6
U4: ESP32-S3-WROOM-1-N8R8; ESP32-S3-WROOM-1
U5: TPS3823-33DBV; SOT-23-5
U6: 74LVC1G08; SOT-23-5
U7, U8: INA180A2; SOT-23-5
U9, U10: DRV8871DDA; Texas_HTSOP-8-1EP_3.9x4.9mm_P1.27mm_EP2.95x4.9mm_Mask2.4x3.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

Connections:
/BATT_NTC: C3.1, J1.3, R3.2, U4.7 (IO7)
/BST_5V: C7.1, U1.6 (VBST)
/BUCK_EN: R12.2, U1.5 (EN)
/CC1: J3.A5 (CC1), R15.1
/CC2: J3.B5 (CC2), R16.1
/CHG_EN: Q3.1 (G), R5.1, U4.34 (IO41)
/CHG_G: Q2.1 (G), Q3.3 (D), R4.2
/DBG_RX: J9.3, U4.36 (RXD0)
/DBG_TX: J9.2, U4.37 (TXD0)
/DOCK_DATA: D3.1 (A1), J2.3, R9.2, R10.1, R11.2
/DOCK_ID: J2.4, R8.1
/DOCK_RX: R10.2, U4.33 (IO40)
/DOCK_TX: R9.1, U4.32 (IO39)
/DOCK_VSENSE: C4.1, R6.2, R7.1, U4.12 (IO8)
/ENC_L_A: J4.5, R28.2, U4.19 (IO11)
/ENC_L_B: J4.6, R29.2, U4.20 (IO12)
/ENC_R_A: J5.5, R30.2, U4.21 (IO13)
/ENC_R_B: J5.6, R31.2, U4.22 (IO14)
/ESP_EN: C15.1, R17.2, SW1.1, U4.3 (EN)
/ESP_IO0: R18.2, SW2.1, U4.27 (IO0)
/FB_5V: R13.2, R14.1, U1.4 (VFB)
/GND: C1.2, C2.2, C3.2, C4.2, C5.2, C6.2, C8.2, C9.2, C10.2, C11.2, C12.2, C13.2, C14.2, C15.2, C16.2, C17.2, C18.2, C19.2, C20.2, C21.2, C22.2, C23.2, C24.2, C25.2, C26.2, D1.2 (A2), D3.2 (A2), H1.1, H2.1, H3.1, H4.1, J1.2, J2.2, J3.A1 (GND), J3.A12 (GND), J3.B1 (GND), J3.B12 (GND), J3.SH (SHIELD), J4.4, J5.4, J6.3, J6.4, J7.1, J8.3, J8.8, J9.4, Q1.1 (G), Q3.2 (S), Q4.2 (S), Q7.2 (S), R2.2, R5.2, R7.2, R8.2, R14.2, R15.2, R16.2, R19.2, R20.2, R24.2, R25.2, R33.2, R36.2, R37.2, SW1.2, SW2.2, TP8.1, U1.1 (GND), U2.2 (GND), U3.2 (GND), U4.1 (GND), U4.40 (GND), U4.41 (GND), U5.2 (GND), U6.3 (GND), U7.2 (GND), U8.2 (GND), U9.1 (GND), U9.7 (GND), U9.9 (GND), U10.1 (GND), U10.7 (GND), U10.9 (GND)
/I2C_SCL: J7.4, J8.5, R35.2, U4.38 (IO2)
/I2C_SDA: J7.3, J8.4, R34.2, U4.39 (IO1)
/ILIM_L: R24.1, U9.4 (ILIM)
/ILIM_R: R25.1, U10.4 (ILIM)
/IMOT_L: C23.1, R26.2, TP5.1, U4.5 (IO5)
/IMOT_R: C24.1, R27.2, TP6.1, U4.6 (IO6)
/ISNS_L_RAW: R26.1, U7.1
/ISNS_R_RAW: R27.1, U8.1
/LED_K: D6.1 (K), R36.1
/LED_PWR_K: D7.1 (K), R37.1
/LED_STAT: D6.2 (A), U4.10 (IO17)
/MOT_EN: R19.1, U4.23 (IO21), U6.1
/MOT_ENABLE: Q4.1 (G), R20.1, U6.4
/MOT_L_IN1: U4.8 (IO15), U9.3 (IN1)
/MOT_L_IN2: U4.9 (IO16), U9.2 (IN2)
/MOT_L_N: J4.2, U9.8 (OUT2)
/MOT_L_P: J4.1, U9.6 (OUT1)
/MOT_R_IN1: U4.24 (IO47), U10.3 (IN1)
/MOT_R_IN2: U4.35 (IO42), U10.2 (IN2)
/MOT_R_N: J5.2, U10.8 (OUT2)
/MOT_R_P: J5.1, U10.6 (OUT1)
/PI_5V: C26.1, J6.1, J6.2, Q6.3 (D)
/PI_G: Q6.1 (G), Q7.3 (D), R32.2
/PI_PWR_EN: Q7.1 (G), R33.1, U4.11 (IO18)
/PI_RX: J6.6, U4.15 (IO3)
/PI_TX: J6.5, U4.25 (IO48)
/SENS_ADC: J8.7, U4.17 (IO9)
/SENS_GPIO: J8.6, U4.18 (IO10)
/SW_5V: C7.2, L1.1, U1.2 (SW)
/USB_DN: J3.A7 (D-), J3.B7 (D-), U3.3 (I/O2), U3.4 (I/O2), U4.13 (USB_D-)
/USB_DP: J3.A6 (D+), J3.B6 (D+), U3.1 (I/O1), U3.6 (I/O1), U4.14 (USB_D+)
/VBAT: C1.1, C5.1, C6.1, D1.1 (A1), Q1.3 (S), Q2.3 (D), Q5.3 (S), R1.1, R12.1, R21.1, TP1.1, U1.3 (VIN)
/VBAT_F: F1.2, Q1.2 (D)
/VBAT_RAW: F1.1, J1.1
/VBAT_SENSE: C2.1, R1.2, R2.1, U4.4 (IO4)
/VBUS: D5.2 (A), J3.A4 (VBUS), J3.A9 (VBUS), J3.B4 (VBUS), J3.B9 (VBUS), U3.5 (VBUS)
/VCC_3V3: C11.1, C12.1, C13.1, C14.1, C16.1, C17.1, C25.1, D7.2 (A), J4.3, J5.3, J7.2, J8.2, J9.1, R3.1, R11.1, R17.1, R18.1, R28.1, R29.1, R30.1, R31.1, R34.1, R35.1, TP3.1, U2.5 (VOUT), U4.2 (3V3), U5.3 (~MR), U5.5 (V_{DD}), U6.5 (VCC), U7.5 (V+), U8.5 (V+)
/VCC_5V: C8.1, C9.1, D4.2 (A), J8.1, L1.2, Q6.2 (S), R13.1, R32.1, TP2.1
/VCHG: D2.2 (A), J2.1, R6.1
/VCHG_D: D2.1 (K), Q2.2 (S), R4.1
/VM_G: Q4.3 (D), Q5.1 (G), R21.2
/VM_L: C19.1, C20.1, R22.2, U7.4 (-), U9.5 (VM)
/VM_R: C21.1, C22.1, R23.2, U8.4 (-), U10.5 (VM)
/VM_SW: C18.1, Q5.2 (D), R22.1, R23.1, TP4.1, U7.3 (+), U8.3 (+)
/V_LDO_IN: C10.1, D4.1 (K), D5.1 (K), U2.1 (VIN), U2.3 (EN)
/WDI: U4.31 (IO38), U5.4 (WDI)
/WDT_OK: TP7.1, U5.1 (~RESET), U6.2
