md-sazzad-eee/ATLAS/02_electronics/agent_controller/atlas_agent_ctrl.kicad_pcb

## KiCad design 02_electronics/agent_controller/atlas_agent_ctrl.kicad_pcb (continued)

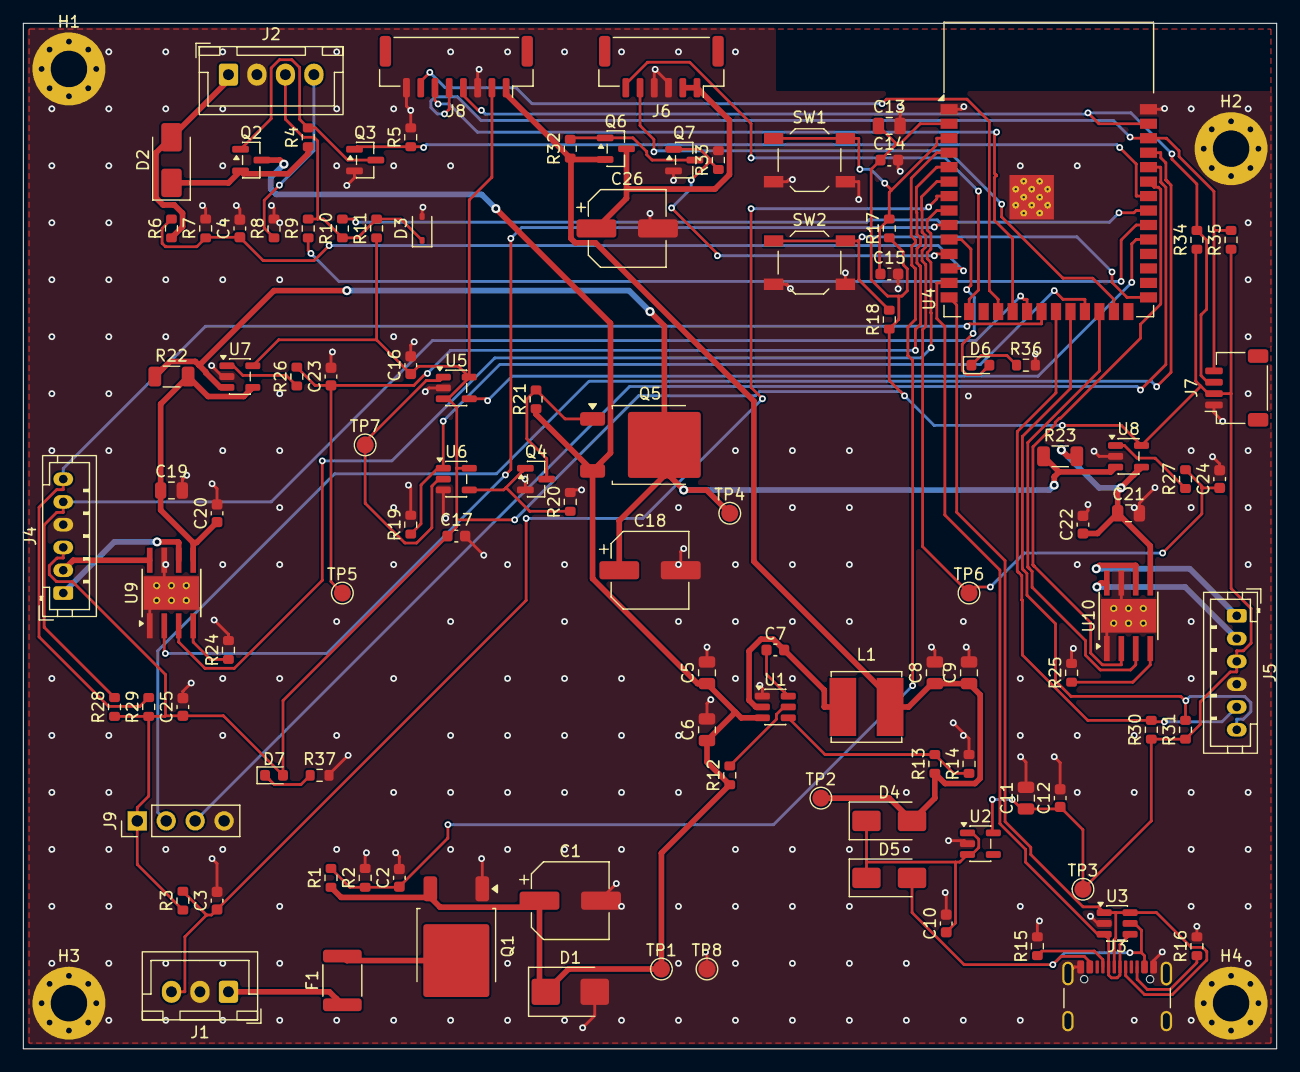
[picture p31: board atlas_agent_ctrl.kicad_pcb from above]

Board: 2 copper layers, 110.0 x 90.0 mm, 112 parts (0 on the bottom side), 69 nets.
