md-sazzad-eee/ATLAS/02_electronics/dock_charger/atlas_dock_charger.kicad_pcb

## KiCad design 02_electronics/dock_charger/atlas_dock_charger.kicad_pcb (2026-10-15)

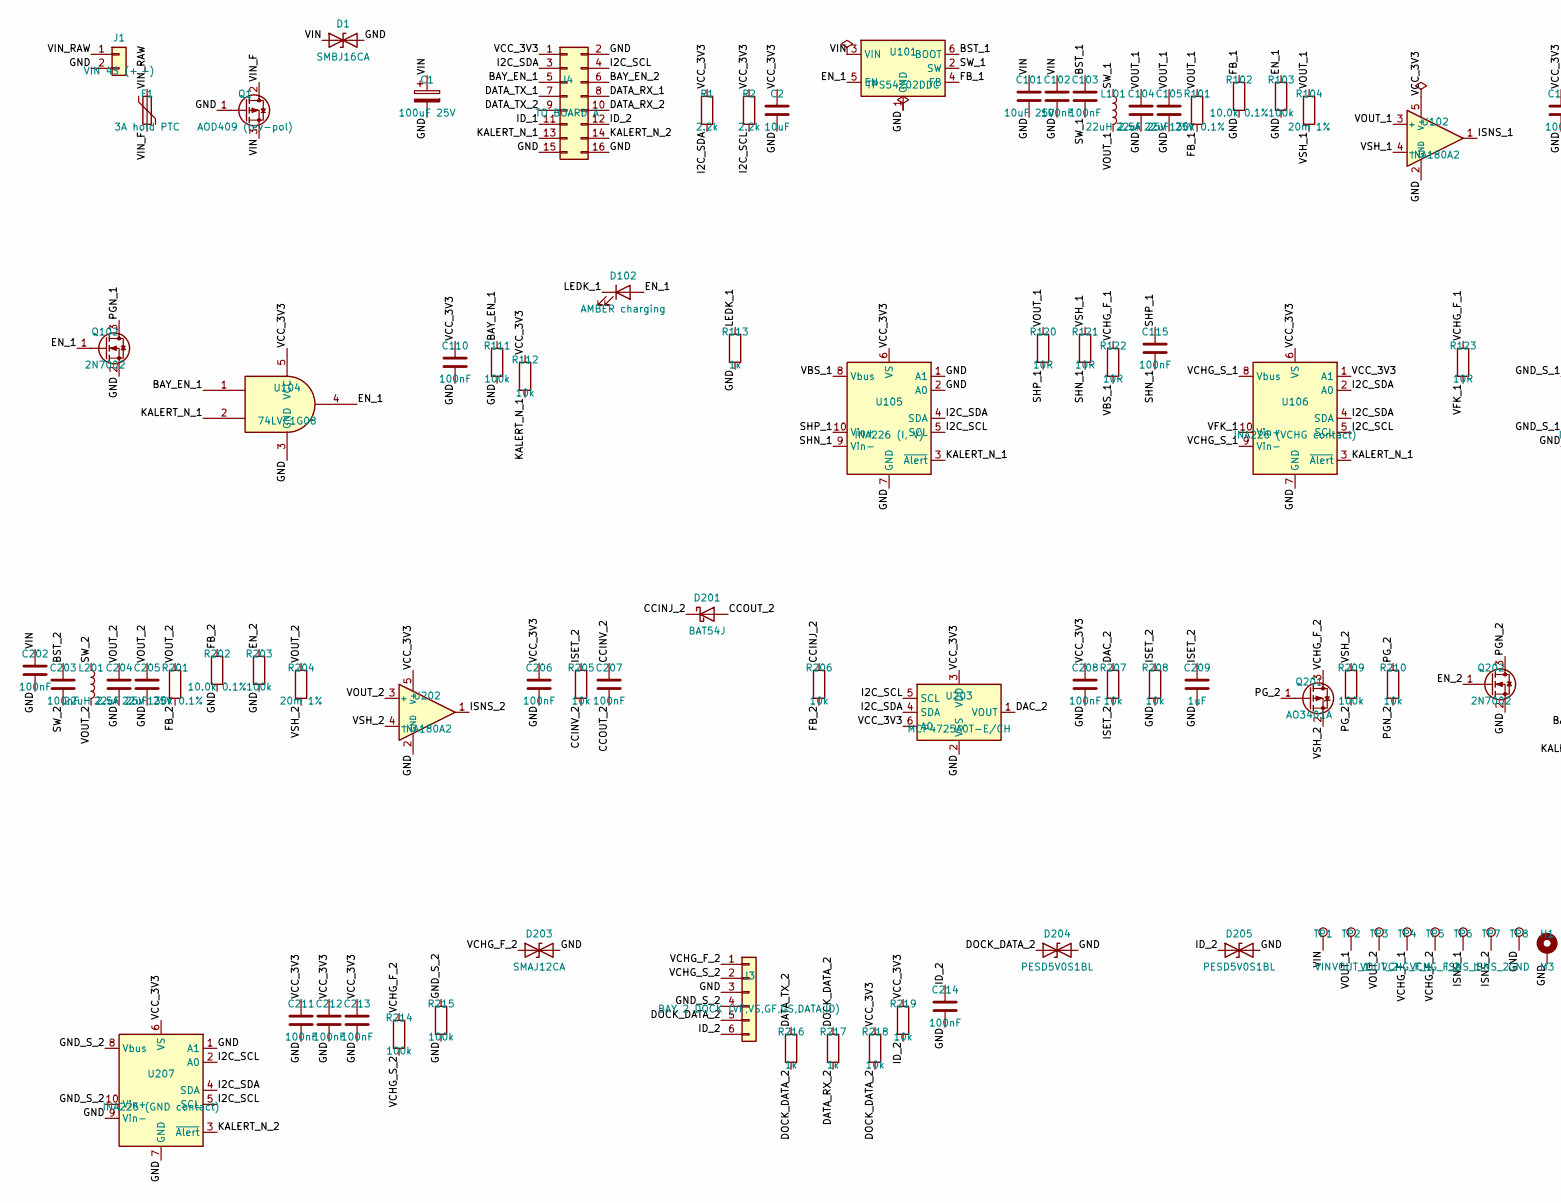
[picture p32: schematic atlas_dock_charger.kicad_sch, ATLAS Board C (dock / charge interface on the carrier), part in row 1, column 1]

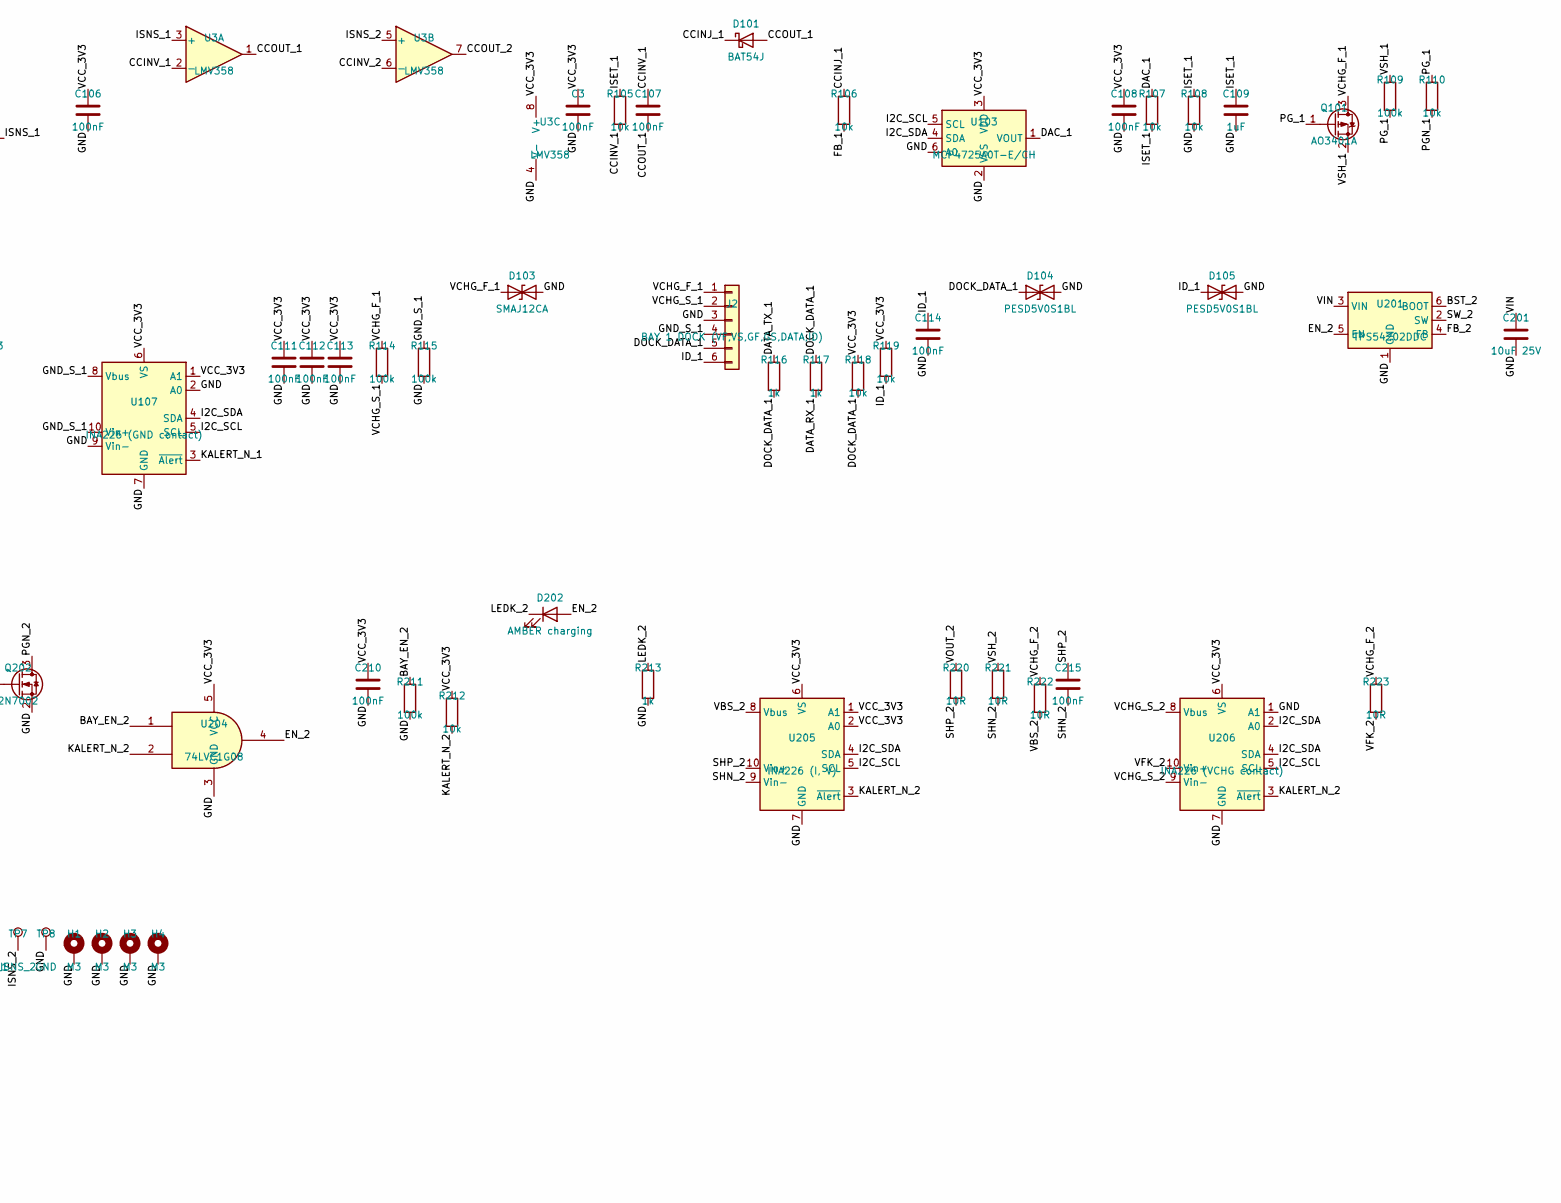
[picture p33: schematic atlas_dock_charger.kicad_sch, ATLAS Board C (dock / charge interface on the carrier), part in row 1, column 2]

Parts:
C1: 100uF 25V; CP_Elec_8x10
C2: 10uF; C_0805_2012Metric
C3, C102, C103, C106, C107, C108, C110, C111, C112, C113, C114, C115, C202, C203, C206, C207, C208, C210, C211, C212, C213, C214, C215: 100nF; C_0603_1608Metric
C101, C201: 10uF 25V; C_1206_3216Metric
C104, C105, C204, C205: 22uF 25V; C_1206_3216Metric
C109, C209: 1uF; C_0603_1608Metric
D1: SMBJ16CA; D_SMB
D101, D201: BAT54J; D_SOD-323
D102, D202: AMBER charging; LED_0603_1608Metric
D103, D203: SMAJ12CA; D_SMA
D104, D105, D204, D205: PESD5V0S1BL; D_SOD-323
F1: 3A hold PTC; Fuse_1812_4532Metric
H1, H2, H3, H4: M3; MountingHole_3.2mm_M3_Pad_Via
J1: VIN 4S (+,-); AMASS_XT30PW-M_1x02_P2.50mm_Horizontal
J2: BAY 1 DOCK (VF,VS,GF,GS,DATA,ID); JST_XH_B6B-XH-A_1x06_P2.50mm_Vertical
J3: BAY 2 DOCK (VF,VS,GF,GS,DATA,ID); JST_XH_B6B-XH-A_1x06_P2.50mm_Vertical
J4: TO BOARD A; PinHeader_2x08_P2.54mm_Vertical
L101, L201: 22uH 2.5A; L_Bourns_SRR1260
Q1: AOD409 (rev-pol); TO-252-2
Q101, Q201: AO3401A; SOT-23
Q102, Q202: 2N7002; SOT-23
R1, R2: 2.2k; R_0603_1608Metric
R101, R201: 130k 0.1%; R_0603_1608Metric
R102, R202: 10.0k 0.1%; R_0603_1608Metric
R103, R109, R111, R114, R115, R203, R209, R211, R214, R215: 100k; R_0603_1608Metric
R104, R204: 20m 1%; R_1206_3216Metric
R105, R106, R107, R108, R110, R112, R118, R119, R205, R206, R207, R208, R210, R212, R218, R219: 10k; R_0603_1608Metric
R113, R116, R117, R213, R216, R217: 1k; R_0603_1608Metric
R120, R121, R122, R123, R220, R221, R222, R223: 10R; R_0603_1608Metric
TP1: VIN; TestPoint_Pad_D1.5mm
TP2: VOUT_1; TestPoint_Pad_D1.5mm
TP3: VOUT_2; TestPoint_Pad_D1.5mm
TP4: VCHG_F_1; TestPoint_Pad_D1.5mm
TP5: VCHG_F_2; TestPoint_Pad_D1.5mm
TP6: ISNS_1; TestPoint_Pad_D1.5mm
TP7: ISNS_2; TestPoint_Pad_D1.5mm
TP8: GND; TestPoint_Pad_D1.5mm
U3: LMV358; SOIC-8_3.9x4.9mm_P1.27mm
U101, U201: TPS54202DDC; SOT-23-6
U102, U202: INA180A2; SOT-23-5
U103, U203: MCP4725A0T-E/CH; SOT-23-6
U104, U204: 74LVC1G08; SOT-23-5
U105, U205: INA226 (I, V); MSOP-10_3x3mm_P0.5mm
U106, U206: INA226 (VCHG contact); MSOP-10_3x3mm_P0.5mm
U107, U207: INA226 (GND contact); MSOP-10_3x3mm_P0.5mm

Connections:
/BAY_EN_1: J4.5, R111.1, U104.1
/BAY_EN_2: J4.6, R211.1, U204.1
/BST_1: C103.1, U101.6 (BOOT)
/BST_2: C203.1, U201.6 (BOOT)
/CCINJ_1: D101.1 (K), R106.1
/CCINJ_2: D201.1 (K), R206.1
/CCINV_1: C107.1, R105.2, U3.2 (-)
/CCINV_2: C207.1, R205.2, U3.6 (-)
/CCOUT_1: C107.2, D101.2 (A), U3.1
/CCOUT_2: C207.2, D201.2 (A), U3.7
/DAC_1: R107.1, U103.1 (VOUT)
/DAC_2: R207.1, U203.1 (VOUT)
/DATA_RX_1: J4.8, R117.2
/DATA_RX_2: J4.10, R217.2
/DATA_TX_1: J4.7, R116.1
/DATA_TX_2: J4.9, R216.1
/DOCK_DATA_1: D104.1 (A1), J2.5, R116.2, R117.1, R118.2
/DOCK_DATA_2: D204.1 (A1), J3.5, R216.2, R217.1, R218.2
/EN_1: D102.2 (A), Q102.1 (G), R103.1, U101.5 (EN), U104.4
/EN_2: D202.2 (A), Q202.1 (G), R203.1, U201.5 (EN), U204.4
/FB_1: R101.2, R102.1, R106.2, U101.4 (FB)
/FB_2: R201.2, R202.1, R206.2, U201.4 (FB)
/GND: C1.2, C2.2, C3.2, C101.2, C102.2, C104.2, C105.2, C106.2, C108.2, C109.2, C110.2, C111.2, C112.2, C113.2, C114.2, C201.2, C202.2, C204.2, C205.2, C206.2, C208.2, C209.2, C210.2, C211.2, C212.2, C213.2, C214.2, D1.2 (A2), D103.2 (A2), D104.2 (A2), D105.2 (A2), D203.2 (A2), D204.2 (A2), D205.2 (A2), H1.1, H2.1, H3.1, H4.1, J1.2, J2.3, J3.3, J4.2, J4.15, J4.16, Q1.1 (G), Q102.2 (S), Q202.2 (S), R102.2, R103.2, R108.2, R111.2, R113.2, R115.2, R202.2, R203.2, R208.2, R211.2, R213.2, R215.2, TP8.1, U3.4 (V-), U101.1 (GND), U102.2 (GND), U103.2 (VSS), U103.6 (A0), U104.3 (GND), U105.1 (A1), U105.2 (A0), U105.7 (GND), U106.7 (GND), U107.2 (A0), U107.7 (GND), U107.9 (Vin-), U201.1 (GND), U202.2 (GND), U203.2 (VSS), U204.3 (GND), U205.7 (GND), U206.1 (A1), U206.7 (GND), U207.1 (A1), U207.7 (GND), U207.9 (Vin-)
/GND_S_1: J2.4, R115.1, U107.8 (Vbus), U107.10 (Vin+)
/GND_S_2: J3.4, R215.1, U207.8 (Vbus), U207.10 (Vin+)
/I2C_SCL: J4.4, R2.2, U103.5 (SCL), U105.5 (SCL), U106.5 (SCL), U107.5 (SCL), U203.5 (SCL), U205.5 (SCL), U206.5 (SCL), U207.2 (A0), U207.5 (SCL)
/I2C_SDA: J4.3, R1.2, U103.4 (SDA), U105.4 (SDA), U106.2 (A0), U106.4 (SDA), U107.4 (SDA), U203.4 (SDA), U205.4 (SDA), U206.2 (A0), U206.4 (SDA), U207.4 (SDA)
/ID_1: C114.1, D105.1 (A1), J2.6, J4.11, R119.2
/ID_2: C214.1, D205.1 (A1), J3.6, J4.12, R219.2
/ISET_1: C109.1, R105.1, R107.2, R108.1
/ISET_2: C209.1, R205.1, R207.2, R208.1
/ISNS_1: TP6.1, U3.3 (+), U102.1
/ISNS_2: TP7.1, U3.5 (+), U202.1
/KALERT_N_1: J4.13, R112.2, U104.2, U105.3 (~Alert), U106.3 (~Alert), U107.3 (~Alert)
/KALERT_N_2: J4.14, R212.2, U204.2, U205.3 (~Alert), U206.3 (~Alert), U207.3 (~Alert)
/LEDK_1: D102.1 (K), R113.1
/LEDK_2: D202.1 (K), R213.1
/PGN_1: Q102.3 (D), R110.2
/PGN_2: Q202.3 (D), R210.2
/PG_1: Q101.1 (G), R109.2, R110.1
/PG_2: Q201.1 (G), R209.2, R210.1
/SHN_1: C115.2, R121.2, U105.9 (Vin-)
/SHN_2: C215.2, R221.2, U205.9 (Vin-)
/SHP_1: C115.1, R120.2, U105.10 (Vin+)
/SHP_2: C215.1, R220.2, U205.10 (Vin+)
/SW_1: C103.2, L101.1, U101.2 (SW)
/SW_2: C203.2, L201.1, U201.2 (SW)
/VBS_1: R122.2, U105.8 (Vbus)
/VBS_2: R222.2, U205.8 (Vbus)
/VCC_3V3: C2.1, C3.1, C106.1, C108.1, C110.1, C111.1, C112.1, C113.1, C206.1, C208.1, C210.1, C211.1, C212.1, C213.1, J4.1, R1.1, R2.1, R112.1, R118.1, R119.1, R212.1, R218.1, R219.1, U3.8 (V+), U102.5 (V+), U103.3 (VDD), U104.5 (VCC), U105.6 (VS), U106.1 (A1), U106.6 (VS), U107.1 (A1), U107.6 (VS), U202.5 (V+), U203.3 (VDD), U203.6 (A0), U204.5 (VCC), U205.1 (A1), U205.2 (A0), U205.6 (VS), U206.6 (VS), U207.6 (VS)
/VCHG_F_1: D103.1 (A1), J2.1, Q101.3 (D), R114.1, R122.1, R123.1, TP4.1
/VCHG_F_2: D203.1 (A1), J3.1, Q201.3 (D), R214.1, R222.1, R223.1, TP5.1
/VCHG_S_1: J2.2, R114.2, U106.8 (Vbus), U106.9 (Vin-)
/VCHG_S_2: J3.2, R214.2, U206.8 (Vbus), U206.9 (Vin-)
/VFK_1: R123.2, U106.10 (Vin+)
/VFK_2: R223.2, U206.10 (Vin+)
/VIN: C1.1, C101.1, C102.1, C201.1, C202.1, D1.1 (A1), Q1.3 (S), TP1.1, U101.3 (VIN), U201.3 (VIN)
/VIN_F: F1.2, Q1.2 (D)
/VIN_RAW: F1.1, J1.1
/VOUT_1: C104.1, C105.1, L101.2, R101.1, R104.1, R120.1, TP2.1, U102.3 (+)
/VOUT_2: C204.1, C205.1, L201.2, R201.1, R204.1, R220.1, TP3.1, U202.3 (+)
/VSH_1: Q101.2 (S), R104.2, R109.1, R121.1, U102.4 (-)
/VSH_2: Q201.2 (S), R204.2, R209.1, R221.1, U202.4 (-)

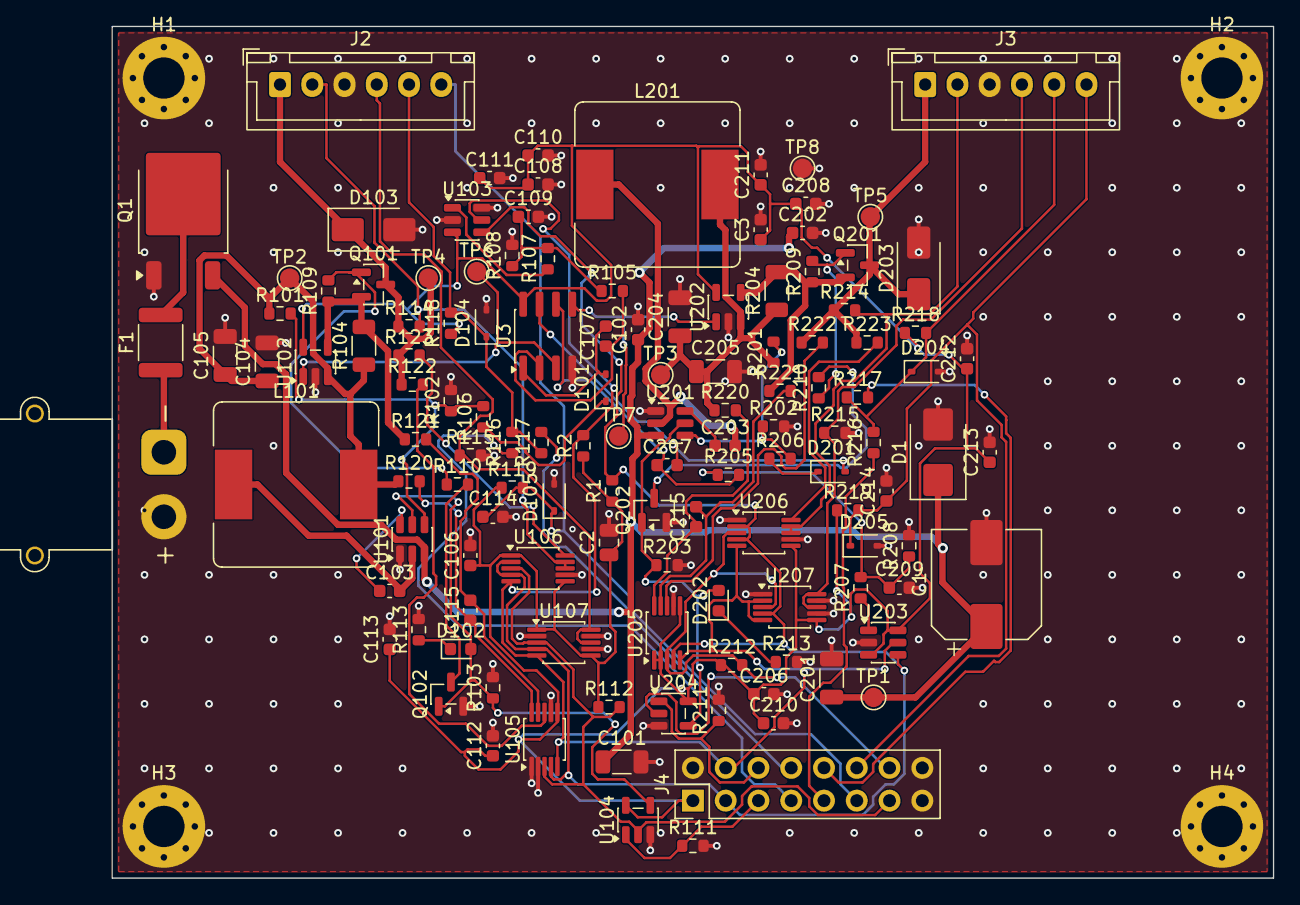
[picture p34: board atlas_dock_charger.kicad_pcb from above]

Board: 2 copper layers, 90.0 x 66.0 mm, 131 parts (0 on the bottom side), 63 nets.
